SREESAIARJUN/radxa-cm4-nano-carrier/artifacts/rev11_hdmi_tmds_report.md

# Rev 11.0 - HDMI0 TMDS length-matching verification report

Generated by `python3 tools/hdmi_tmds.py verify` from the saved `.kicad_pcb` (lengths measured segment-by-segment by pcbnew, DRC by kicad-cli with the project `.kicad_dru`).

| # | Check | Result | Detail |
|---|---|---|---|
| 1 | J4 Micro-HDMI D (XUNPU HDMI-101S, LCSC C720620) present on B.Cu | PASS | radxa-cm4-nano-carrier:HDMI_Micro-D_XUNPU_HDMI-101S |
| 2 | J4 pinout = HDMI Type D (3/5 D2, 6/8 D1, 9/11 D0, 12/14 CLK, 4/7/10/13/16/shell GND, 1 HPD, 15 CEC, 17 SCL, 18 SDA, 19 +5V) | PASS | ok |
| 3 | J4 copper >= 0.30 mm from the Y=40 edge, mouth inside the outline (zero overhang) | PASS | front shell-pad copper Y 39.660 (gap 0.340); mouth Y 39.75 (recess 0.25 mm) |
| 4 | J4 courtyard clear of the H4 standoff keep-out (d6.2) | PASS | courtyard X 39.85..48.15; gap 0.25 mm |
| 5 | J4 courtyard does not overlap any other bottom-side part | PASS | clear |
| 6 | J4 through-hole shell legs clear of the J2 DF40 body on the top side | PASS | leftmost leg copper X 40.15 > DF40 body end X 36.3 |
| 7 | J4 orientation: rear row (D2/D0) Y 33.615, front row (D1/CLK) Y 34.835, mouth toward +Y | PASS | rear [33.615, 33.615], front [34.835, 34.835] |
| 8 | All 8 TMDS nets routed | PASS | 8/8 |
| 9 | Track width 0.165 mm on every TMDS segment | PASS | {'HDMI0_TX2_P': [0.165], 'HDMI0_TX2_N': [0.165], 'HDMI0_TX1_P': [0.165], 'HDMI0_TX1_N': [0.165], 'HDMI0_TX0_P': [0.165], 'HDMI0_TX0_N': [0.165], 'HDMI0_CLK_P': [0.165], 'HDMI0_CLK_N': [0.165]} |
| 10 | Exactly one F.Cu<->B.Cu via per TMDS net (via barrel cancels in all comparisons) | PASS | {'HDMI0_TX2_P': 1, 'HDMI0_TX2_N': 1, 'HDMI0_TX1_P': 1, 'HDMI0_TX1_N': 1, 'HDMI0_TX0_P': 1, 'HDMI0_TX0_N': 1, 'HDMI0_CLK_P': 1, 'HDMI0_CLK_N': 1} |
| 11 | Inter-pair: all 8 nets within 0.15 mm (max-min) | PASS | 45.1256 .. 45.1256 mm, spread 0.0 um = 0.000 ps |
| 12 | Intra-pair TX2: |P-N| <= 0.15 mm | PASS | P 45.1256  N 45.1256  skew 0.00 um = 0.0000 ps |
| 13 | Intra-pair TX1: |P-N| <= 0.15 mm | PASS | P 45.1256  N 45.1256  skew 0.00 um = 0.0000 ps |
| 14 | Intra-pair TX0: |P-N| <= 0.15 mm | PASS | P 45.1256  N 45.1256  skew 0.00 um = 0.0000 ps |
| 15 | Intra-pair CLK: |P-N| <= 0.15 mm | PASS | P 45.1256  N 45.1256  skew 0.00 um = 0.0000 ps |
| 16 | Coupled-section edge gap = 0.125 mm (+/-5 um) on every pair | PASS | TX2 0.1250..0.1250; TX1 0.1250..0.1250; TX0 0.1250..0.1250; CLK 0.1250..0.1250 |
| 17 | Longest contiguous uncoupled stretch <= 1.0 mm (5.5 ps << 50 ps edge; bumps, fan-outs and chamfers measured along the copper, trace inside its own pad excluded) | PASS | TX2 0.847 mm (coupled 78.8 % of copper); TX1 0.936 mm (coupled 82.7 % of copper); TX0 0.847 mm (coupled 80.7 % of copper); CLK 0.936 mm (coupled 83.6 % of copper) |
| 18 | Pair-to-pair copper gap >= 0.4 mm (no crossings) | PASS | min 0.400 mm (HDMI0_TX1_N/HDMI0_CLK_P on F.Cu) |
| 19 | Every TMDS segment runs over filled GND on its reference plane (In1 under F.Cu, In2 under B.Cu), incl. +/-0.28 mm lateral margin - never across the ETH_SHIELD split | PASS | 10827 samples, 0 off-plane (465 inside the 0.75 mm via-transition zones excluded) |
| 20 | GND return via (or grounded shell leg) within 2.0 mm of every TMDS layer-change via | PASS | HDMI0_CLK_N 1.33, HDMI0_CLK_P 0.93, HDMI0_TX0_N 1.72, HDMI0_TX0_P 1.72, HDMI0_TX1_N 0.93, HDMI0_TX1_P 1.33, HDMI0_TX2_N 1.38, HDMI0_TX2_P 0.73 |
| 21 | Insertion length (FR4, odd mode) within HDMI 2.0 carrier budget (< 60 mm) | PASS | 45.13 mm = 249.3 ps |
| 22 | kicad-cli DRC: 0 violations touching TMDS / J4 | PASS | 0 |
| 23 | kicad-cli: 0 unconnected TMDS items (J2 <-> J4 fully routed) | PASS | 0 |
| 24 | J4 GND pins 4 (D2 shield), 16 (DDC/CEC GND) and the shell legs are connected to GND | PASS | unconnected J4 GND pads: ['10', '13', '7'] |
| 25 | MUTATION caught: TMDS N trace +0.20 mm -> skew | PASS | 2 new 'skew_out_of_range' violation(s) on TMDS copper, e.g. Skew between traces out of range (rule 'hdmi0_tmds_skew_TX2' max skew 0.0750 mm; actual 0. |
| 26 | MUTATION caught: GND track 0.15 mm from a TMDS trace -> clearance (hdmi0_tmds_to_other) | PASS | 1 new 'clearance' violation(s) on TMDS copper, e.g. Clearance violation (rule 'hdmi0_tmds_to_other' clearance 0.2000 mm; actual 0.1500 mm) |

**26/26 checks passed.**

Informational (not gating):

- kicad-cli DRC, items NOT touching TMDS/J4 (owned by other stages, e.g. tools/ethernet_mdi.py): 9: silk_overlap 4, silk_over_copper 2, text_height 2, silk_edge_clearance 1
- J4 shield pins 7 (D1), 10 (D0), 13 (CLK) - KNOWN OPEN (no via/stub site in this escape; Rev 12 item): unconnected now: ['10', '13', '7']
- J4 low-speed nets not yet routed (HPD/CEC/DDC/+5V: out of Rev 11 scope): HDMI0_CEC, HDMI0_HOTPLUG, HDMI0_SCL, HDMI0_SDA

## Routed length per net (pad centre to pad centre, incl. stubs; 1 via each)

| Net | Length mm | vs longest um | Delta ps |
|---|---|---|---|
| HDMI0_TX2_P | 45.1256 | -0.0 | -0.000 |
| HDMI0_TX2_N | 45.1256 | -0.0 | -0.000 |
| HDMI0_TX1_P | 45.1256 | -0.0 | -0.000 |
| HDMI0_TX1_N | 45.1256 | +0.0 | +0.000 |
| HDMI0_TX0_P | 45.1256 | -0.0 | -0.000 |
| HDMI0_TX0_N | 45.1256 | -0.0 | -0.000 |
| HDMI0_CLK_P | 45.1256 | -0.0 | -0.000 |
| HDMI0_CLK_N | 45.1256 | -0.0 | -0.000 |

Odd-mode delay 5.523 ps/mm (eeff 2.742); HDMI 2.0 UI at 5.94 Gbit/s = 168.4 ps; 0.15 mm = 0.83 ps = 0.49 % UI.
