SREESAIARJUN/radxa-cm4-nano-carrier/artifacts/rev13_buck_3v3_report.md

# Rev 13 - SY8089AAAC +3V3_SYS buck: layout verification report

Generated by `python3 tools/buck_3v3.py verify` from the saved `.kicad_pcb` (measured, not planned).

**35/35 checks pass.**

| # | Check | Result | Detail |
|---|---|---|---|
| 1 | All 12 parts present (U5, U6, L1, C40-C44, R40-R43) | PASS | 12/12 |
| 2 | Pad-to-net map matches SY8089 / MAX809 pinouts + schematic intent (28 pads) | PASS | 28/28 |
| 3 | All power-stage parts on B.Cu (top side is under the CM4 module) | PASS |  |
| 4 | U5 / U6 pin positions = plan (mirror-correct flip) | PASS | max err 0.0 um |
| 5 | Every courtyard encloses its own pads (KiCad does not check this) | PASS | all |
| 6 | C41 (100 nF HF) pad edge <= 0.5 mm from U5 IN (pin 4) | PASS | 0.480 mm |
| 7 | C40 (22 uF bulk) pad edge <= 2.5 mm from U5 IN (pin 4) | PASS | 1.575 mm |
| 8 | U5 GND has an under-body via to L3 (hot-loop return directly beneath the IC) | PASS | (13.0, 4.9) |
| 9 | HF input loop plan-view area <= 4.0 mm^2 (C41 / IN / GND / under-body via) | PASS | 3.77 mm^2, perimeter 9.80 mm, est. L_loop ~6.63 nH (excl. package) |
| 10 | Bulk input loop plan-view area <= 8.0 mm^2 (C40) | PASS | 6.66 mm^2 |
| 11 | LX node copper area <= 12 mm^2 (pin 3 + trace + L1 pad; datasheet rule 3) | PASS | 9.29 mm^2 |
| 12 | LX trace length <= 3.0 mm | PASS | 2.35 mm |
| 13 | FB copper (tracks AND pads) >= 1.0 mm from any LX copper (true segment/box distance) | PASS | 1.61 mm |
| 14 | FB node trace length <= 5 mm (pin 5 -> divider) | PASS | 3.65 mm |
| 15 | VOUT sensed at C43 pad (Kelvin, after the output caps), not at L1 | PASS |  |
| 16 | Sense trace >= 0.7 mm from LX copper | PASS | 0.80 mm |
| 17 | +5V_IN / LX tracks >= 0.6 mm (2.4 A peak, 1 oz outer: < 10 C rise) | PASS | min 0.60 mm |
| 18 | Via count by net in the stage envelope (0.3 mm drill): +5V_IN >= 2, +3V3_SYS >= 2 hand-off, GND >= 8 | PASS | +5V_IN 2, +3V3_SYS 2, GND 10 (current capacity applies once the PDN stage connects the hand-offs) |
| 19 | All courtyards inside the cell envelope | PASS | courtyard bbox (3.35, 1.0, 23.93, 9.99) in (3.3, 0.3, 25.2, 10.05) |
| 20 | Courtyards >= 0.3 mm inside the 55 x 40 outline | PASS |  |
| 21 | No other stage's B.Cu courtyard / pad / track / via inside the cell envelope (+0.3 mm) | PASS | clear |
| 22 | Every courtyard clears every M2.5 standoff circle (r 3.1 mm) | PASS | min 3.21 mm (U6 to H1) |
| 23 | GND planes on L2 + L3 and local B.Cu GND island present | PASS | BUCK_GND_BCU@B.Cu, GND_In1@In1.Cu, GND_In2@In2.Cu |
| 24 | L3 GND copper is actually filled beneath U5 (hot-loop return plane present) | PASS |  |
| 25 | Every buck GND via lands in filled L3 GND (no via inside another stage's plane notch) | PASS | all |
| 26 | Buck COPPER >= 2.0 mm from any *SHIELD* zone (Ethernet chassis isolation gap) | PASS | 2.08 mm to ETH_SHIELD |
| 27 | Rev 13 DRC block + BUCK_POWER net class present in .kicad_dru / .kicad_pro | PASS | run `buck_3v3.py rules` if another stage dropped them |
| 28 | Electrical design checks (27) all pass | PASS | 0 failing |
| 29 | kicad-cli DRC: 0 violations touching the buck stage / cell (excl. documented hand-off vias) | PASS | 0 |
| 30 | Open hand-offs (informational):  | PASS | none |
| 31 | No hand-off left open on a net another stage has already routed | PASS | consistent |
| 32 | No unconnected items internal to the power stage (only the 2 documented inter-stage links remain) | PASS | 0 internal; 6 touching buck nets (J1 +5V_IN / +3V3_OUT / GND fan-out = next PDN stage) |
| 33 | NEGATIVE CONTROL: ungrouped 0.2 mm +5V_IN J1 fan-out NOT caught by buck_power_width | PASS | 0 width violations on the control stub |
| 34 | MUTATION caught: FB stub from U5 pin 5 to 0.7 mm of LX copper -> rule buck_fb_lx_isolation | PASS | clearance: Clearance violation (netclass 'Default' clearance 0.2000 mm; actual 0.; clearance: Clearance violation (rule 'buck_fb_lx_isolation' clearance 1.0000 mm; ; clearance: Clearance violation (zone clearance 0.2500 mm; actual 0.0000 mm) |
| 35 | MUTATION caught: +5V_IN 0.3 mm neck-down (member of REV13 group) from the VIN entry via -> rule buck_power_width | PASS | clearance: Clearance violation (zone clearance 0.2500 mm; actual 0.0000 mm); track_width: Track width (board setup constraints min width 0.5500 mm; actual 0.300 |

## Design calculation checks

| Check | Result | Detail |
|---|---|---|
| Vout setpoint within 1 % of 3.300 V | PASS | 0.6 x (1 + 100k/22.1k) = 3.3149 V |
| Vout DC worst case (VREF +/-2 %, R +/-0.35 %) inside 3.3 V +/-5 % | PASS | 3.230 .. 3.401 V (window 3.135 .. 3.465) |
| Divider resistors inside datasheet 10k..1M range | PASS | R1 100k, R2 22.1k, I_div 27.1 uA |
| Datasheet L rule: L >= Vout(1-Vout/Vin,max)/(fsw*0.4*Iout) | PASS | L_rule 1.53 uH -> 2.2 uH (FNR4030S2R2MT, also the datasheet's own typical value) |
| Ripple ratio at nominal L/fsw, VIN,max in 20%..40% | PASS | dI = 555 mA p-p = 27.8 % of 2.0 A |
| Worst-corner peak current < Isat (L -20 %, fsw -20 %, VIN 5.5 V) | PASS | Ipk 2.47 A vs Isat 5.8 A (dI_wc 935 mA) |
| Isat > IC current limit (no saturation during OCP / hic-cup) | PASS | Isat 5.8 A > ILIM,min 3.5 A (ILIM max not specified -> 66 % headroom) |
| Inductor RMS current < Irms rating | PASS | 2.018 A vs 3.2 A |
| Inductor DCR < 50 mOhm (datasheet efficiency guideline) | PASS | 39 mOhm |
| Ripple stays >= 10 % at the low corner (current-mode ramp / light-load PFM entry) | PASS | dI_min 316 mA (15.8 %) at VIN 4.75 V, L +20 %, fsw +20 % |
| Min on-time margin (D_min / fsw,max >> 75 ns) | PASS | ton = 502 ns at VIN 5.5 V, fsw +20 % (limit 75 ns) |
| Regulation headroom at 2 A (100 % duty dropout) below VIN,min | PASS | VIN needed 3.72 V vs USB VIN,min 4.75 V (D_max 77.5 %) |
| Cin RMS ripple current handled by 22 uF X5R (self-heating < 10 mW) | PASS | I_rms 0.945 A (worst VIN=2Vout bound 1.00 A), P_ESR 4.0 mW |
| Input ripple at IN pin, worst USB VIN corner 4.75..5.25 V (C -20 %, fsw -20 %, L -20 %, DC-bias derated) | PASS | dVin 95.8 mV p-p at VIN 5.25 V (C_eff 6.8 uF) vs 100 mV; 106 mV at the 5.5 V IC limit (outside USB VBUS range) |
| Output ripple (worst corner) < 1 % Vout | PASS | dVout 9.81 mV p-p (C_eff 18.4 uF) |
| 1 A load-step LC energy deviation (inductor slew bound) < 3 % Vout | PASS | undershoot 50.0 mV, overshoot 21.6 mV (lower bound; loop-delay term measured on the bench) |
| Vout TOTAL window (DC + IFB*R1 + ripple/2 + 1 A step) inside 3.3 V +/-5 % | PASS | 3.170 .. 3.432 V (margins 35 / 33 mV) |
| Cff phase-boost centre within 0.5x..2x of the datasheet-validated network | PASS | zero 33.9 kHz, pole 187 kHz, max boost 44 deg at 80 kHz (datasheet 1.8 V example: 63 kHz); LC pole 22.4 kHz |
| Same L / Cout as datasheet typical application (internal compensation validated region) | PASS | 2.2 uH, 2 x 22 uF |
| Soft-start Cout charge current << ILIM | PASS | 122 mA over 1.2 ms |
| EN high level (U6 VOH = +3V3_OUT) >= VIH 1.5 V and <= VIN + 0.6 V | PASS | V_EN 3.27 V |
| Power-down: +3V3_SYS shut off while +3V3_OUT >= Vth,min, back-bias < ESD onset | PASS | U6 trips at +3V3_OUT 2.85..3.00 V -> max +3V3_SYS - +3V3_OUT 0.58 V < 0.6 V (plain 10k/1M from +3V3_OUT: EN-off only below 0.40 V) |
| Power-up: buck enabled >= 140 ms after +3V3_OUT valid (module rail first) | PASS | t_RP 140 ms min; RESET# low for VCC 1.0 V..Vth; R43 1M holds EN low with module absent |
| EN clamp current limited if +5V_IN collapses first (10k series) | PASS | <= 0.29 mA into EN ESD diode with VIN = 0 |
| Efficiency at 2 A / 5 V >= 88 % | PASS | 89.7 % (1 A: 94.5 %), P_IC 606 mW, P_L+div 157 mW |
| TJ <= 125 C at 2 A, TA 50 C (board-estimated thetaJA, self-consistent RDS(on)(TJ)) | PASS | TJ 120 C @ 115 C/W (166 C @ datasheet 170 C/W) |
| Carrier 3V3 load budget 1.2 A <= derated limit at TA 70 C (datasheet thetaJA, conservative) | PASS | I_max(70 C) = 1.42 A @170 C/W, 1.75 A @115 C/W |

## Thermal derating (TJ <= 125 C)

| TA (C) | I_max @ 170 C/W (datasheet) | I_max @ 115 C/W (board est.) |
|---|---|---|
| 25 | 1.95 A | 2.00 A |
| 40 | 1.79 A | 2.00 A |
| 50 | 1.68 A | 2.00 A |
| 60 | 1.55 A | 1.91 A |
| 70 | 1.42 A | 1.75 A |
| 85 | 1.19 A | 1.47 A |

kicad-cli DRC (whole board): 9 violations, 59 unconnected items (board-wide; most are the J1/J2 fan-out owned by later stages).
