SREESAIARJUN/radxa-cm4-nano-carrier/artifacts/rev17_power_seq_report.md

# Rev 17 - Power sequencing (GLOBAL_EN / RUN / PWR_OK): verification report

Generated by `python3 tools/power_sequencing.py verify` from the saved `.kicad_pcb` (measured, not planned).

**20/20 layout checks pass.**

| # | Check | Result | Detail |
|---|---|---|---|
| 1 | All 9 Rev 17 parts present (R55, R54, R56, R51, R52, U8, R53, C50, U7) | PASS |  |
| 2 | Stage items grouped in REV17_PWR_SEQ (additive / idempotent regeneration) | PASS | 64 items |
| 3 | Pad-to-net map = MIC803 / TPS3808 DBV pinouts + schematic intent | PASS | all pads |
| 4 | Pad positions = plan (incl. mirrored B.Cu parts) | PASS | max err 0.0 um |
| 5 | Layer assignment: links + bridge on F.Cu, supervisors on B.Cu | PASS |  |
| 6 | Default (RADXA) build: U7, R54, R55 DNP; R51, R52, R53, R56, U8, C50 fitted | PASS | matches VARIANTS |
| 7 | Default build: J1 pin 99 (GLOBAL_EN) has no fitted carrier part (no pull-up, no driver) | PASS | attached: R54(DNP) |
| 8 | Default build: J1 pin 92 (RUN_PG) has no fitted carrier part (no pull-up, no driver) | PASS | attached: R55(DNP) |
| 9 | Default build: J1 pin 100 (nEXTRST) has no fitted carrier part (no pull-up, no driver) | PASS | attached: none |
| 10 | Rev 13 hand-off closed: J1 +3V3_OUT (84/86) copper-connected to U6 VCC (MAX809 pin 3) | PASS | continuous F.Cu trace under the R55/R54/R56 0603 bridges, south run y = 9.98 mm |
| 11 | Top-side (under-module) parts <= 1.2 mm | PASS | R51/R52 0402 0.4 mm, R54/R55/R56 0603 0.55 mm |
| 12 | Rev 17 copper >= 1.70 mm lateral from the ETH_SHIELD inner-layer island (3-D >= 1.71 mm through 7628 prepreg; the only sub-2 mm item is the forced +3V3_OUT south run) | PASS | min 1.74 mm lateral / 1.76 mm 3-D (+3V3_OUT @(18.20,5.25)) |
| 13 | Every courtyard clears every M2.5 standoff circle (r 3.1 mm) | PASS | min 13.30 mm |
| 14 | Every Rev 17 GND via lands in filled L2 AND L3 GND | PASS | all |
| 15 | Rev 17 DRC block present in .kicad_dru | PASS | run `power_sequencing.py rules` if dropped |
| 16 | Sequencing design checks (25) all pass | PASS | 0 failing |
| 17 | kicad-cli DRC: 0 violations touching Rev 17 items / nets | PASS | 0 |
| 18 | No unconnected items on Rev 17 nets | PASS | 0 (2 J1/J2 GND-pad fan-out gaps pre-date Rev 17 and merely pair with the nearest GND via) |
| 19 | MUTATION caught: GND stub 0.225 mm from the RUN_PG trace (passes the 0.2 mm default, must trip only -> pseq_module_pin_isolation | PASS | Clearance violation (rule 'pseq_module_pin_isolation' clearance 0.2500 mm; actua; Track has unconnected end |
| 20 | Schematic: 9 Rev 17 symbols, DNP flags = board, ERC clean except the 3 J1/buck-side labels (GLOBAL_EN, RUN_PG, +5V_IN: J1 and the buck are not in the schematic yet) | PASS | symbols ok, DNP ok, 0 unexpected ERC items |

## Sequencing design checks (`calc`)

| Check | Result | Detail |
|---|---|---|
| U7 max threshold < +5V_IN minimum 4.75 V (a valid supply is never held off) | PASS | VTH,max 4.50 V, margin 250 mV |
| U7 min threshold > MxL7704 UVLO-rising max 3.9 V (GLOBAL_EN asserted before the PMIC can start) | PASS | VTH,min 4.25 V |
| U7 /RESET abs max >= GLOBAL_EN released level (5.25 V, 100k to +5V on CM4) | PASS | 6.0 V >= 5.25 V |
| GLOBAL_EN low level <= 0.8 V (MxL7704 VIL) with 100k module pull-up | PASS | VOL <= 0.3 V at 52 uA sink |
| GLOBAL_EN released level >= 2.0 V (MxL7704 VIH) with U7 leakage | PASS | 4.65 V |
| Power-on GLOBAL_EN low pulse > 1 ms (CM4 restart minimum) | PASS | 140..360 ms after VIN > VTH |
| PWR_OK rising threshold (max, incl. 3 % hysteresis) < +3V3_SYS minimum | PASS | 3.168 V < 3.234 V (margin 66 mV) |
| PWR_OK falling threshold (min) >= lowest +3V3_SYS peripheral VDD 2.7 V | PASS | VIT- 2.756 / 2.912 / 3.076 V |
| SENSE input current error negligible (< 0.5 % of VIT) | PASS | 0.22 mV at Rth 8.61 k |
| U8 VDD (+5V_IN) inside 1.7..6.5 V across the input window | PASS | 4.75..5.25 V |
| PWR_OK valid while +3V3_SYS = 0 V (VDD from always-on +5V_IN, VPOR 0.8 V) | PASS | RESET low from VDD 0.8 V; supervisor NOT powered from the rail it monitors |
| PWR_OK high (R51 100k to +3V3_SYS, RADXA build) >= 2.0 V with 300 nA leakage | PASS | 3.20 V |
| RUN_PG low (RPi build: 10k module pull-up, 220R series, U8 VOL) <= 0.8 V | PASS | 200 mV at 0.32 mA |
| [RADXA (default: RK3566 / RK3576 / RK3588)] R51 (pull-up) and R55 (RUN link) never both fitted | PASS | R51=fit, R55=DNP |
| [RPI_CM4] R51 (pull-up) and R55 (RUN link) never both fitted | PASS | R51=DNP, R55=fit |
| [default build] RPi CM4 (BCM2711 + MxL7704): no static drive on pin 99 / pin 92 unless the module allows it | PASS | pin 99: released; pin 92: released |
| [default build] Radxa CM3 (RK3566 + RK817-5): no static drive on pin 99 / pin 92 unless the module allows it | PASS | pin 99: released; pin 92: released |
| [default build] Radxa CM4 (RK3576 + RK806S-5): no static drive on pin 99 / pin 92 unless the module allows it | PASS | pin 99: released; pin 92: released |
| [default build] Radxa CM5 (RK3588S + RK806-1): no static drive on pin 99 / pin 92 unless the module allows it | PASS | pin 99: released; pin 92: released |
| [RPI_CM4 build] drives only what the RPi CM4 datasheet allows (GLOBAL_EN hold-off, RUN via 220R) | PASS | R54 + R55 fitted, R51 DNP |
| Added capacitance on pin 92 <= 100 nF (RK806 RESETB total <= 0.3 uF, module already ~110 nF) | PASS | 0 nF: only a DNP 0402 pad (~0.1 pF) + trace (~1 pF) |
| Boot-critical rail rule R17-1: +3V3_SYS valid only 141..462 ms after module 3V3, i.e. AFTER every Rockchip reset release (2..16 ms) -> no BootROM device may sit on +3V3_SYS | PASS | requirement recorded in specs/carrier_specs.md; RPi build additionally holds RUN until PWR_OK |
| [RPI_CM4 build] RUN_PG held until PWR_OK: worst-case boot delay < 1 s | PASS | PWR_OK at 153..490 ms after module 3V3 |
| Power-down: PWR_OK asserts (falling VIT max) above the peripheral minimum 2.7 V | PASS | asserts between 2.76 and 3.08 V, tpd 20 us |
| Rejected: replacing U6 by TLV809EC26 (10 ms) - still misses RK806 reset (>= 6.5+0.8 ms vs 5 ms) and raises power-down back-bias above the 0.6 V ESD limit | PASS | back-bias 0.78 V; keep MAX809 + rule R17-1 instead |

## Module compatibility matrix

| Module | Pin 99 | Pin 92 | SoC reset release after module 3V3 | Source |
|---|---|---|---|---|
| RPi CM4 (BCM2711 + MxL7704) | GLOBAL_EN: 100k to +5V, low = PMIC off; hold-off is the intended use | RUN_PG: 10k to 3V3, may be held low via 220R (CPU reset) | 11 ms+ | CM4 datasheet 5.1: +1V8 >= 1 ms after 3V3, RUN_PG >= 10 ms after 1V8; pins 92/99 rows |
| Radxa CM3 (RK3566 + RK817-5) | PWRON_KEY: RK817 PWRON, 17k to VCC_RTC; > 6 s low = OFF (no auto restart with 5 V present) | PMIC_SLEEP_H push-pull SoC output (V1.3) / NC (V1.2) | 2..12 ms | RK817 DS V1.7 4.1.2-4.1.4; Radxa CM3 schematic V1.2 sh.21/23; RK3566 HDG V1.1 (2 ms slots) |
| Radxa CM4 (RK3576 + RK806S-5) | PWRON_L: RK806S PWRON, ~45k to VCCA = 5V; VDC strapped high -> cannot be held off | RESET_L: NPOR + RK806S RESETB, 10k to 1V8; low while ON = PMIC restart | 0..16 ms | Radxa CM4 schematic V1.20 sh.5/19; RK806S DS Rev1.5 4.1.2/4.1.4 (RESETB slot 12) |
| Radxa CM5 (RK3588S + RK806-1) | PWRON_L: RK806 PWRON, ~45k to VCCA = 5V + 100nF; VDC strapped high | RESET_L: NPOR + RK806 RESETB, 10k to 1V8 + 100nF; low while ON = PMIC restart | 5..5 ms | Radxa CM5 X2.1/V2.21 schematic p.8/18; RK806 DS V1.2 Table 4-1 (3V3 slot 6, RESETB slot 11) |

Carrier: +3V3_SYS valid 141..462 ms, PWR_OK 153..490 ms after module 3V3 (U6 MAX809 tRP + SY8089 soft-start + U8 td).

## Assembly variants

| Build | U7 | R54 | R55 | R51 |
|---|---|---|---|---|
| RADXA (default: RK3566 / RK3576 / RK3588) | DNP | DNP | DNP | fit |
| RPI_CM4 | fit | fit | fit | DNP |

kicad-cli DRC (whole board): 9 violations, 59 unconnected (board-wide; other stages' items are reported by their own verifiers).
