SREESAIARJUN/radxa-cm4-nano-carrier/artifacts/rev9_mdi_si_report.md

# Rev 9.0 Gigabit Ethernet MDI - Signal-Integrity & DRC Report

Generated by `tools/ethernet_mdi.py verify`. Impedance source of truth: `tools/mdi_impedance.py`.

**Overall: FAIL** (30/31 checks)

## Impedance (JLC04161H-7628, L4 over L3 / L1 over L2)

| Model | Zdiff | Zodd | Zcomm |
|---|---|---|---|
| 2-D FD field solver, solder-masked (sign-off) | 100.03 | 50.01 | 44.20 |
| 2-D FD field solver, bare copper | 104.71 | 52.35 | 45.06 |
| Kirschning-Jansen closed form, bare | 111.06 | 55.53 | 44.70 |

Geometry W = 0.165 mm, S = 0.125 mm, pitch 0.290 mm; eeff(odd) 2.742 -> 5.523 ps/mm.

## Intra-pair lengths (track + one 1.5512 mm F.Cu->B.Cu barrel per via, as KiCad's skew rule counts them)

| Segment | P (mm) | N (mm) | Skew (mm) | Uncoupled (mm, P leg) |
|---|---|---|---|---|
| PHY0 | 42.945 | 42.945 | 0.000 | 8.76 |
| PHY1 | 28.921 | 28.921 | 0.000 | 4.71 |
| PHY2 | 39.865 | 39.865 | 0.000 | 6.29 |
| PHY3 | 26.109 | 26.109 | 0.000 | 4.74 |
| CAB0 | 7.981 | 7.981 | 0.000 | 3.76 |
| CAB1 | 7.529 | 7.529 | 0.000 | 7.53 |
| CAB2 | 11.599 | 11.599 | 0.000 | 5.13 |
| CAB3 | 7.455 | 7.455 | 0.000 | 3.76 |

## Checks

| ID | Check | Result | Detail |
|---|---|---|---|
| STK-prepreg | board stackup L1-L2 / L3-L4 prepreg == impedance model | PASS | h=0.2104 er=4.4 |
| PRO-netclass | ETH_MDI_100R (W 0.165 / gap 0.125 / via 0.5/0.3) + patterns present in .kicad_pro | PASS | classes ['Default', 'BUCK_POWER', 'ETH_MDI_100R', 'HDMI_TMDS']; patterns ['ETH_MDI*', 'Ethernet_Pair*'] |
| DRU-block | Rev 9 DRU block present (net-name conditions; skew constraint = half the P-N limit) | PASS |  |
| ZDIFF-fd | field-solver Zdiff of W0.165/S0.125 within +/-3 % of 100 ohm | PASS | 100.03 ohm |
| NET-count | 16 MDI nets routed (4 PHY-side + 4 cable-side pairs) | PASS | ETH_MDI0_N, ETH_MDI0_P, ETH_MDI1_N, ETH_MDI1_P, ETH_MDI2_N, ETH_MDI2_P, ETH_MDI3_N, ETH_MDI3_P, Ethernet_Pair0_N, Ethernet_Pair0_P, Ethernet_Pair1_N, Ethernet_Pair1_P, Ethernet_Pair2_N, Ethernet_Pair2_P, Ethernet_Pair3_N, Ethernet_Pair3_P |
| GEO-width | every MDI segment is 0.165 mm wide | PASS | [0.165] |
| MAP-t568 | CM4 Pair0..3 -> T1 TD1..TD4 -> MX1..MX4 -> RJ45 1/2, 3/6, 4/5, 7/8 (T568) | PASS | all 16 |
| MAP-polarity | end-to-end polarity: Pair_P and MDI_P on the same winding end (dot/non-dot) of the same channel; MDI_P on RJ45 '+' | PASS |  |
| MAP-j1 | J1 pins 3..12 carry Ethernet_Pair0..3 per CM4 pinout | PASS |  |
| LEN-skew | intra-pair length mismatch <= 0.15 mm (all 8 pair segments) | PASS | PHY0 42.945/42.945 d=0.000; PHY1 28.921/28.921 d=0.000; PHY2 39.865/39.865 d=0.000; PHY3 26.109/26.109 d=0.000; CAB0 7.981/7.981 d=0.000; CAB1 7.529/7.529 d=0.000; CAB2 11.599/11.599 d=0.000; CAB3 7.455/7.455 d=0.000 |
| LEN-total | each side <= 50.0 mm (PHY pin->T1, T1->RJ45) | PASS | max 42.95 mm; J1->RJ45 totals 50.9, 36.5, 51.5, 33.6 mm |
| CPL-uncoupled | uncoupled length per net <= 10.0 mm (DRU diff_pair_uncoupled) | PASS | PHY0 8.76; PHY1 4.71; PHY2 6.29; PHY3 4.74; CAB0 3.76; CAB1 7.53; CAB2 5.13; CAB3 3.76 |
| CPL-RL | uncoupled sections' return-loss contribution < -30 dB at 100 MHz | PASS | Zdiff(uncoupled) 141.7 ohm, worst PHY0: 8.76 mm -> -39.6 dB |
| SPC-interpair | pair-to-pair edge spacing >= 0.3 mm (DRU mdi_interpair) | PASS | min 0.495 mm (Ethernet_Pair0_N/Ethernet_Pair2_P) |
| GEO-gap | no intra-pair pinch: min P-N edge gap >= coupled gap 0.125 mm (centre pitch 0.290) | PASS | min 0.125 mm (PHY0) |
| REF-plane | every MDI segment has a solid plane directly beneath (In1 for F.Cu, In2 for B.Cu) | PASS | 0 voids |
| REF-domain | PHY-side pairs over GND, cable-side pairs over ETH_SHIELD (never across the split) | PASS | 0 crossings |
| MECH-side | T1, J3 and 1206 HV parts on the bottom side (top side is under the module, <= 1.2 mm) | PASS |  |
| MECH-top-height | top-side Ethernet passives are 0402 (<= 0.55 mm) under the 1.2 mm limit | PASS | 8 top-side parts; non-0402: none |
| MECH-envelope | T1/J3 courtyards inside 55 x 40 outline (zero overhang) | PASS | T1 (25.45, 10.96, 42.55, 29.05), J3 (0.3, 12.4, 21.89, 27.59) |
| DRC-eth | kicad-cli DRC: 0 violations involving any Rev 9 item (group REV9_ETH_MDI) or Ethernet net | PASS | 0 |
| DRC-unrouted | no unrouted Ethernet connections (all 16 MDI + CT/BS/shield nets complete) | PASS | 0 |
| DRC-other | pre-existing non-Ethernet DRC items (informational) | PASS | 9 violations, 59 unrouted (J1/J2 module nets / other stages) |
| MUT-track_width | DRU catches mutation: MDI segment widened to 0.25 mm -> track_width | PASS | 1 matching 'track_width' violations; types ['clearance', 'silk_edge_clearance', 'silk_over_copper', 'silk_overlap', 'text_height', 'track_width'] |
| MUT-mdi_isolation | DRU catches mutation: GND track 0.25 mm from an MDI band -> mdi_isolation | PASS | 1 matching 'clearance' violations; types ['clearance', 'silk_edge_clearance', 'silk_over_copper', 'silk_overlap', 'text_height', 'track_dangling'] |
| MUT-mdi_interpair | DRU catches mutation: foreign MDI pair 0.25 mm from Pair 2 -> mdi_interpair | PASS | 1 matching 'clearance' violations; types ['clearance', 'silk_edge_clearance', 'silk_over_copper', 'silk_overlap', 'skew_out_of_range', 'text_height', 'track_dangling', 'track_width'] |
| MUT-skew | DRU catches mutation: 0.20 mm stub on ETH_MDI3_N -> skew | PASS | 2 matching 'skew_out_of_range' violations; types ['silk_edge_clearance', 'silk_over_copper', 'silk_overlap', 'skew_out_of_range', 'text_height'] |
| MUT-via_count | DRU catches mutation: 3rd via on Ethernet_Pair3_P -> via_count | **FAIL** | 0 matching 'too_many_vias' violations; types ['clearance', 'hole_clearance', 'shorting_items', 'silk_edge_clearance', 'silk_over_copper', 'silk_overlap', 'text_height'] |
| MUT-eth_shield_split | DRU catches mutation: ETH_BS via inside the 2 mm split -> eth_shield_split | PASS | 2 matching 'clearance' violations; types ['clearance', 'silk_edge_clearance', 'silk_over_copper', 'silk_overlap', 'text_height', 'via_dangling'] |
| SCH-erc | schematic ERC: no violations on Rev 9 symbols (only the 8 J1-side Ethernet_PairN labels dangle) | PASS | 8 total; unexpected: none |
| SCH-parity | schematic <-> PCB parity clean for T1, J3, C10..C15, R10..R14 (refs, values, footprints, nets) | PASS | 0 Rev 9 parity items (32 board-wide, J1/J2/other stages) |
