SREESAIARJUN/radxa-cm4-nano-carrier/artifacts/rev15_thermal_report.md

# Rev 15 - 15 W continuous-load thermal study: heat pipe vs. solid thermal pedestal

Generated by `python3 tools/thermal_15w.py calc` (do not hand-edit). Inputs, sources and assumptions are listed in the tool header; every [A] assumption is swept below.

**Recommended concept: B1** - Cu block + 6 mm flattened sintered heat pipe -> 135x100x20 remote sink (natural).  **18/19 gating checks pass**; 7/7 solver self-tests pass.

## 0. Decision matrix (gate: TA 40 C, 15 W at the SoC, worst-case TIM)

Rule: meet TJ <= 80 C at TA 40 C with worst-case TIM AND mass on the module <= 60 g; passive preferred over fan (no wear-out item, no acoustic noise); then lowest TJ.

| Concept | TJ worst TIM | thermal gate | mass on module | mass gate | feasible |
|---|---|---|---|---|---|
| A5 | 76.0 C | PASS | 53 g | PASS | **yes** |
| B1 **(recommended)** | 79.0 C | PASS | 23 g | PASS | **yes** |
| A4 | 80.2 C | fail | 237 g | fail | no |
| A3 | 96.8 C | fail | 53 g | PASS | no |
| A2 | 100.5 C | fail | 237 g | fail | no |
| A1 | 154.2 C | fail | 37 g | PASS | no |

## 1. Junction temperature, 15 W concentrated at the SoC

| Concept | TA | TJ nom | TJ worst TIM | T_case | T_sink root | T_module (DF40) | T_carrier | R_sa K/W | R_ja,eff K/W | fins / gap |
|---|---|---|---|---|---|---|---|---|---|---|
| A1 | 25 | 137.3 | 140.0 | 134.5 | 109.8 | 114.1 | 101.1 | 6.72 | 7.01 | 10 / 5.0 mm |
| A1 | 40 | 151.6 | 154.2 | 148.8 | 124.2 | 128.2 | 114.8 | 6.74 | 6.97 | 9 / 5.8 mm |
| A1 | 50 | 161.0 | 163.6 | 158.2 | 133.6 | 137.5 | 123.8 | 6.74 | 6.93 | 9 / 5.8 mm |
| A2 | 25 | 82.7 | 85.6 | 79.8 | 52.8 | 62.2 | 61.3 | 1.89 | 3.60 | 16 / 7.9 mm |
| A2 | 40 | 97.7 | 100.5 | 94.8 | 67.8 | 77.1 | 75.8 | 1.90 | 3.60 | 16 / 7.9 mm |
| A2 | 50 | 107.6 | 110.4 | 104.7 | 77.7 | 86.8 | 85.4 | 1.90 | 3.59 | 15 / 8.6 mm |
| A3 | 25 | 78.6 | 81.5 | 75.6 | 49.6 | 59.0 | 58.8 | 1.66 | 3.35 | 20 / 1.8 mm |
| A3 | 40 | 93.9 | 96.8 | 91.0 | 65.0 | 74.1 | 73.6 | 1.70 | 3.37 | 19 / 2.0 mm |
| A3 | 50 | 104.0 | 106.9 | 101.1 | 75.2 | 84.2 | 83.3 | 1.71 | 3.38 | 19 / 2.0 mm |
| A4 | 25 | 65.1 | 65.1 | 61.7 | 53.1 | 56.9 | 57.2 | 1.89 | 2.51 | 16 / 7.9 mm |
| A4 | 40 | 80.2 | 80.2 | 76.8 | 68.1 | 71.8 | 71.7 | 1.90 | 2.51 | 16 / 7.9 mm |
| A4 | 50 | 90.0 | 90.0 | 86.6 | 78.0 | 81.6 | 81.3 | 1.89 | 2.50 | 15 / 8.6 mm |
| A5 | 25 | 60.6 | 60.6 | 57.1 | 49.9 | 53.5 | 54.5 | 1.66 | 2.22 | 20 / 1.8 mm |
| A5 | 40 | 76.0 | 76.0 | 72.5 | 65.3 | 68.8 | 69.4 | 1.70 | 2.25 | 19 / 2.0 mm |
| A5 | 50 | 86.2 | 86.2 | 82.7 | 75.5 | 78.8 | 79.2 | 1.71 | 2.26 | 19 / 2.0 mm |
| B1 | 25 | 64.1 | 64.1 | 60.6 | 52.6 | 57.7 | 57.9 | 1.90 | 2.44 | 16 / 7.9 mm |
| B1 | 40 | 79.0 | 79.0 | 75.5 | 67.6 | 72.5 | 72.3 | 1.91 | 2.43 | 16 / 7.9 mm |
| B1 | 50 | 88.8 | 88.8 | 85.3 | 77.5 | 82.3 | 81.9 | 1.90 | 2.42 | 15 / 8.6 mm |

## 2. Distributed load (11.5 W SoC + 3.5 W DRAM/PMIC/eMMC into the module PCB)

| Concept | TA | TJ nom | T_module | T_carrier |
|---|---|---|---|---|
| A1 | 25 | 131.7 | 118.2 | 104.2 |
| A1 | 40 | 146.0 | 132.2 | 117.8 |
| A1 | 50 | 155.3 | 141.4 | 126.7 |
| A2 | 25 | 77.7 | 67.1 | 65.1 |
| A2 | 40 | 92.6 | 81.9 | 79.5 |
| A2 | 50 | 102.5 | 91.6 | 89.0 |
| A3 | 25 | 73.7 | 63.8 | 62.6 |
| A3 | 40 | 89.0 | 79.0 | 77.3 |
| A3 | 50 | 99.1 | 88.9 | 87.0 |
| A4 | 25 | 62.9 | 62.6 | 61.6 |
| A4 | 40 | 77.9 | 77.4 | 76.1 |
| A4 | 50 | 87.8 | 87.2 | 85.7 |
| A5 | 25 | 58.6 | 59.3 | 59.0 |
| A5 | 40 | 73.9 | 74.4 | 73.8 |
| A5 | 50 | 84.1 | 84.5 | 83.6 |
| B1 | 25 | 62.3 | 63.8 | 62.6 |
| B1 | 40 | 77.2 | 78.6 | 77.0 |
| B1 | 50 | 87.0 | 88.3 | 86.5 |

## 2b. Governed operation (OS throttles at 85 C): power and board temperatures actually reached

| Concept | load | TA | P W | TJ | T_module (DF40) | T_carrier (buck ambient) |
|---|---|---|---|---|---|---|
| A1 | concentrated | 25 | 6.7 | 85.0 | 75.1 | 71.3 |
| A1 | concentrated | 40 | 4.6 | 85.0 | 78.4 | 76.9 |
| A1 | concentrated | 50 | 3.3 | 85.0 | 80.5 | 80.5 |
| A1 | distributed | 25 | 7.1 | 85.0 | 79.1 | 74.4 |
| A1 | distributed | 40 | 4.8 | 85.0 | 81.2 | 79.0 |
| A1 | distributed | 50 | 3.4 | 85.0 | 82.5 | 82.0 |
| A2 | concentrated | 25 | 15.0 | 82.7 | 62.2 | 61.3 |
| A2 | concentrated | 40 | 11.2 | 85.0 | 69.8 | 70.2 |
| A2 | concentrated | 50 | 8.4 | 85.0 | 73.9 | 75.4 |
| A2 | distributed | 25 | 15.0 | 77.7 | 67.1 | 65.1 |
| A2 | distributed | 40 | 12.5 | 85.0 | 76.2 | 75.2 |
| A2 | distributed | 50 | 9.3 | 85.0 | 78.7 | 79.1 |
| A3 | concentrated | 25 | 15.0 | 78.6 | 59.0 | 58.8 |
| A3 | concentrated | 40 | 12.4 | 85.0 | 68.9 | 69.5 |
| A3 | concentrated | 50 | 9.5 | 85.0 | 72.9 | 74.6 |
| A3 | distributed | 25 | 15.0 | 73.7 | 63.8 | 62.6 |
| A3 | distributed | 40 | 13.7 | 85.0 | 76.0 | 75.0 |
| A3 | distributed | 50 | 10.5 | 85.0 | 78.3 | 78.8 |
| A4 | concentrated | 25 | 15.0 | 65.1 | 56.9 | 57.2 |
| A4 | concentrated | 40 | 15.0 | 80.2 | 71.8 | 71.7 |
| A4 | concentrated | 50 | 12.7 | 85.0 | 78.0 | 78.6 |
| A4 | distributed | 25 | 15.0 | 62.9 | 62.6 | 61.6 |
| A4 | distributed | 40 | 15.0 | 77.9 | 77.4 | 76.1 |
| A4 | distributed | 50 | 13.6 | 85.0 | 84.6 | 83.6 |
| A5 | concentrated | 25 | 15.0 | 60.6 | 53.5 | 54.5 |
| A5 | concentrated | 40 | 15.0 | 76.0 | 68.8 | 69.4 |
| A5 | concentrated | 50 | 14.5 | 85.0 | 78.0 | 78.6 |
| A5 | distributed | 25 | 15.0 | 58.6 | 59.3 | 59.0 |
| A5 | distributed | 40 | 15.0 | 73.9 | 74.4 | 73.8 |
| A5 | distributed | 50 | 15.0 | 84.1 | 84.5 | 83.6 |
| B1 | concentrated | 25 | 15.0 | 64.1 | 57.7 | 57.9 |
| B1 | concentrated | 40 | 15.0 | 79.0 | 72.5 | 72.3 |
| B1 | concentrated | 50 | 13.2 | 85.0 | 79.4 | 79.6 |
| B1 | distributed | 25 | 15.0 | 62.3 | 63.8 | 62.6 |
| B1 | distributed | 40 | 15.0 | 77.2 | 78.6 | 77.0 |
| B1 | distributed | 50 | 14.0 | 85.0 | 86.3 | 84.9 |

## 3. Thermal resistance breakdown at the gate corner (TA 40 C, 15 W, nominal TIM), K/W

- **A1** - tim 1.823, pedestal 0.133, pedestal_sp 0.076, base 0.268, base_sp 0.261; R_sa 6.74; h 8.9 W/m2K.  Heat flows: sink 12.49 W, module_surface 0.61 W, carrier 2.91 W, jb 3.90 W, module_to_carrier 1.90 W, module_to_dissipator 1.39 W.
- **A2** - tim 1.823, pedestal 0.132, pedestal_sp 0.076, base 0.378, base_sp 0.377; R_sa 1.90; h 5.2 W/m2K.  Heat flows: sink 14.63 W, module_surface 0.21 W, carrier 1.18 W, jb 3.44 W, module_to_carrier 0.16 W, module_to_dissipator 3.07 W.
- **A3** - tim 1.823, pedestal 0.132, pedestal_sp 0.075, base 0.265, base_sp 0.258; R_sa 1.70; h 33.6 W/m2K; fan operating point 2.08 CFM @ 6.9 Pa, channel 1.81 m/s.  Heat flows: sink 14.74 W, module_surface 0.19 W, carrier 1.09 W, jb 3.29 W, module_to_carrier 0.08 W, module_to_dissipator 3.03 W.
- **A4** - tim 0.125, pedestal 0.132, pedestal_sp 0.076, base 0.378, base_sp 0.377; R_sa 1.90; h 5.2 W/m2K.  Heat flows: sink 14.82 W, module_surface 0.17 W, carrier 1.02 W, jb 1.40 W, module_to_carrier 0.01 W, module_to_dissipator 1.22 W.
- **A5** - tim 0.125, pedestal 0.132, pedestal_sp 0.075, base 0.265, base_sp 0.258; R_sa 1.70; h 33.6 W/m2K; fan operating point 2.08 CFM @ 6.9 Pa, channel 1.81 m/s.  Heat flows: sink 14.93 W, module_surface 0.15 W, carrier 0.93 W, jb 1.20 W, module_to_carrier -0.08 W, module_to_dissipator 1.13 W.
- **B1** - tim 0.125, block_and_evap 0.229, vapour 0.003, condenser 0.025, base 0.174, base_sp 0.172; R_sa 1.91; h 5.1 W/m2K.  Heat flows: sink 14.50 W, module_surface 0.48 W, carrier 1.04 W, jb 1.08 W, module_to_carrier 0.03 W, module_to_dissipator 0.57 W.

## 4. Sustained power before the 85 C trip, transient and mass

| Concept | P_sustain 25 C | 40 C | 50 C | 40 C worst TIM | t to 85 C trip @40 C | tau63 | TJ after 4 h (steady) | dissipator mass | on module |
|---|---|---|---|---|---|---|---|---|---|
| A1 | 6.7 W | 4.6 W | 3.3 W | 4.5 W | 1.3 min | 5.1 min | 124.7 C (151.6) | 33 g | 37 g |
| A2 | 15.7 W | 11.2 W | 8.4 W | 10.6 W | 8.6 min | 2.8 min | 91.7 C (97.7) | 233 g | 237 g |
| A3 | 16.9 W | 12.4 W | 9.5 W | 11.8 W | 3.2 min | 0.8 min | 88.7 C (93.9) | 49 g | 53 g |
| A4 | 24.6 W | 17.3 W | 12.7 W | 17.3 W | never | 5.4 min | 75.6 C (80.2) | 233 g | 237 g |
| A5 | 25.8 W | 18.9 W | 14.5 W | 18.9 W | never | 1.3 min | 72.2 C (76.0) | 49 g | 53 g |
| B1 | 25.6 W | 17.9 W | 13.2 W | 17.9 W | never | 5.9 min | 74.3 C (79.0) | 257 g | 23 g |

Sizing (natural convection, TJ <= 80 C at TA 40 C, worst-case carrier heat): 
- A2: minimum remote/overhanging sink 374 x 272 x 20 mm fins (2446 cm^3)
- A4: minimum remote/overhanging sink 137 x 99 x 20 mm fins (326 cm^3)
- B1: minimum remote/overhanging sink 131 x 96 x 20 mm fins (301 cm^3)

## 5. Heat-pipe operating envelope (B1)

Flattened 6 mm pipe: width 8.00 mm, vapour core 6.40 x 0.90 mm (A_v 5.58 mm^2), wick 7.70 mm^2, L_total 125 mm, L_eff 85 mm. Evaporator flux 9.4 W/cm^2.

| Condition | T_v C | capillary | viscous | sonic | entrainment | boiling | governing Q_max |
|---|---|---|---|---|---|---|---|
| operating, horizontal | 70.6 | 36.4 | 3.43e+03 | 490 | 326 | 48.0 | **36.4 W (capillary)** |
| operating, 90 deg adverse | 70.6 | 32.9 | 3.43e+03 | 490 | 326 | 48.0 | **32.9 W (capillary)** |
| cold start 0 C | 0.0 | 9.4 | 2.16 | 11.4 | 59.1 | 48.0 | **2.2 W (viscous)** |
| cold start 20 C | 20.0 | 16.9 | 27.4 | 41.3 | 107 | 48.0 | **16.9 W (capillary)** |

Cold start: Q_max reaches 15 W at T_v = 16.0 C; from a 0 C soak the stalled evaporator (C = 4.8 J/K) self-heats there in 5.1 s at 15 W - far below the throttle time constant. water pipe: storage/operation below 0 C freezes the working fluid (sintered wicks tolerate freeze-thaw; cold start then follows this self-heating path).

Maximum adverse tilt (evaporator above condenser) keeping 1.5 x 15 W: **90 deg** at operating T_v; carrying 15 W from a 20 C soak: 90 deg.

## 6. Rigid-pedestal TIM tolerance stack

| Contributor | +/- mm |
|---|---|
| standoff length (module-top seat -> sink base underside) | 0.05 |
| pedestal machined height | 0.03 |
| sink base flatness under pedestal | 0.03 |
| BGA ball collapse | 0.05 |
| package substrate + die height | 0.07 |
| module PCB local bow at SoC (IPC-6012 0.75 % over 15 mm, half) | 0.06 |
| die tilt across 8 mm (coplanarity) | 0.03 |
| **Worst case / RSS** | **0.32 / 0.127** |

Gap-pad window 0.50..0.90 mm (1.0 mm pad, 10..50 % compression), nominal gap 0.70 mm, worst-case thick gap 0.83 mm, pedestal height 1.70 mm. The heat-pipe block is spring-loaded, so its phase-change BLT is independent of this stack.

## 7. Sensitivity of TJ to the unpublished SoC/heat-pipe parameters (TA 40 C, 15 W)

| Concept | base TJ | thetaJC x0.5 | thetaJC x2 | thetaJB x0.5 | thetaJB x2 | die 6x6 mm | die 10x10 mm |
|---|---|---|---|---|---|---|---|
| A3 | 93.9 | -1.1 K | +2.2 K | -3.2 K | +3.0 K | +12.0 K | -6.8 K |
| B1 | 79.0 | -1.6 K | +3.1 K | -0.4 K | +0.3 K | +1.9 K | -0.9 K |

B1 additional: R_evap x2 (0.40 K cm2/W) +1.6 K, R_cond x2 +0.3 K

## 8. Checks

| Check | Gate | Result | Detail |
|---|---|---|---|
| Rigid-pedestal TIM gap: RSS stack fits the gap-pad 10..50 % compression window | yes | PASS | stack RSS +/-0.127 mm in window 0.50..0.90 mm (nominal 0.70); 'worst TIM' columns use nominal + RSS = 0.83 mm |
| Rigid-pedestal TIM gap: arithmetic worst-case stack fits the window (info: RSS is the release criterion) | info | **FAIL** | stack WC +/-0.32 mm (RSS 0.127) vs window 0.50..0.90 mm, nominal 0.70 mm, pedestal 1.70 mm |
| Gap-pad clamp load on the SoC package at 50 % compression <= 40 N | yes | PASS | 31.5 N over 15 x 15 mm (0.14 MPa) |
| Heat-pipe evaporator spring preload <= 40 N on the package (phase-change TIM needs >= 0.1 MPa) | yes | PASS | 30 N -> 0.13 MPa |
| Recommended concept B1: mass carried by the compute module <= 60 g | yes | PASS | 23 g |
| A1: energy balance closes (|Qin - Qout| < 1 mW) at the gate corner | yes | PASS | Qin 16.013 W, Qout 16.013 W |
| A2: energy balance closes (|Qin - Qout| < 1 mW) at the gate corner | yes | PASS | Qin 16.013 W, Qout 16.013 W |
| A3: energy balance closes (|Qin - Qout| < 1 mW) at the gate corner | yes | PASS | Qin 16.013 W, Qout 16.013 W |
| A4: energy balance closes (|Qin - Qout| < 1 mW) at the gate corner | yes | PASS | Qin 16.013 W, Qout 16.013 W |
| A5: energy balance closes (|Qin - Qout| < 1 mW) at the gate corner | yes | PASS | Qin 16.013 W, Qout 16.013 W |
| B1: energy balance closes (|Qin - Qout| < 1 mW) at the gate corner | yes | PASS | Qin 16.013 W, Qout 16.013 W |
| Recommended concept B1: TJ <= 80 C (trip 85 C - 5 K) at TA 40 C, 15 W continuous, worst-case TIM | yes | PASS | TJ 79.0 C nominal / 79.0 C worst TIM |
| Recommended concept B1: TJ < critical trip 115 C at TA 50 C (no shutdown) | yes | PASS | TJ 88.8 C; sustained P at 50 C = 13.2 W before throttling |
| A1: DF40 receptacles (module PCB node) <= 85 C at every corner and load split (power capped by the 85 C governor) | info | PASS | max T_module 82.5 C at distributed, TA 50 C, P 3.4 W |
| A2: DF40 receptacles (module PCB node) <= 85 C at every corner and load split (power capped by the 85 C governor) | info | PASS | max T_module 78.7 C at distributed, TA 50 C, P 9.3 W |
| A3: DF40 receptacles (module PCB node) <= 85 C at every corner and load split (power capped by the 85 C governor) | info | PASS | max T_module 78.3 C at distributed, TA 50 C, P 10.5 W |
| A4: DF40 receptacles (module PCB node) <= 85 C at every corner and load split (power capped by the 85 C governor) | info | PASS | max T_module 84.6 C at distributed, TA 50 C, P 13.6 W |
| A5: DF40 receptacles (module PCB node) <= 85 C at every corner and load split (power capped by the 85 C governor) | info | PASS | max T_module 84.5 C at distributed, TA 50 C, P 15.0 W |
| B1: DF40 receptacles (module PCB node) <= 85 C at every corner and load split (power capped by the 85 C governor) | yes | **FAIL** | max T_module 86.3 C at distributed, TA 50 C, P 14.0 W |
| A1: SY8089 buck derated I_max at the carrier temperature >= 1.2 A budget | info | PASS | T_carrier,max 82.0 C (governed) -> I_max 1.53 A (Rev 13 115 C/W model) |
| A2: SY8089 buck derated I_max at the carrier temperature >= 1.2 A budget | info | PASS | T_carrier,max 79.1 C (governed) -> I_max 1.58 A (Rev 13 115 C/W model) |
| A3: SY8089 buck derated I_max at the carrier temperature >= 1.2 A budget | info | PASS | T_carrier,max 78.8 C (governed) -> I_max 1.59 A (Rev 13 115 C/W model) |
| A4: SY8089 buck derated I_max at the carrier temperature >= 1.2 A budget | info | PASS | T_carrier,max 83.6 C (governed) -> I_max 1.50 A (Rev 13 115 C/W model) |
| A5: SY8089 buck derated I_max at the carrier temperature >= 1.2 A budget | info | PASS | T_carrier,max 83.6 C (governed) -> I_max 1.50 A (Rev 13 115 C/W model) |
| B1: SY8089 buck derated I_max at the carrier temperature >= 1.2 A budget | yes | PASS | T_carrier,max 84.9 C (governed) -> I_max 1.47 A (Rev 13 115 C/W model) |
| B1 heat pipe: derated operating limit >= 1.5 x 15 W, horizontal, at operating vapour T | yes | PASS | 36.4 W (capillary) at T_v 70.6 C |
| B1 heat pipe: starts and carries 15 W from a 20 C cold soak (horizontal) | yes | PASS | 16.9 W (capillary) |
| B1 heat pipe: evaporator heat flux < 60 % of sintered-wick CHF (30 W/cm^2) | yes | PASS | 9.4 W/cm^2 |
| B1 heat pipe: >= 1.5x margin up to 30 deg adverse tilt (evaporator above condenser) | yes | PASS | max adverse tilt 90 deg at 22.5 W |
| B1 heat pipe routing: bend radius >= 3 D and pipe clears the M2.5 standoff circles | yes | PASS | R_bend 18 mm, min standoff clearance 9.40 mm, L_total 125 mm |

## 9. Solver self-tests

| Test | Result | Detail |
|---|---|---|
| FD solver == exact 1D slab | PASS | 2.53750 vs 2.53750 K/W |
| Spreading series vs 3D FD, src 10x10 on 40x40x3, h 2000 | PASS | series 0.5745 (R_sp 0.2530) vs FD 0.5737 K/W (+0.14 %) |
| Spreading series vs 3D FD, src 8x30 on 60x50x4, h 300 | PASS | series 1.2631 (R_sp 0.1456) vs FD 1.2644 K/W (-0.10 %) |
| Bar-Cohen S_opt = 2.714 P^-1/4 agrees with the brute-force fin-count optimum (+/-1.5 mm) | PASS | S_opt 7.10 mm vs scan 7.60 mm (16 fins, h 5.58 W/m2K) |
| Capillary limit, round 6 mm sintered, 150 mm, horizontal, 60 C in 25..80 W vendor band | PASS | 39.2 W |
| Churchill-Chu h(40 mm plate, dT 35 K) in 5..9 W/m2K | PASS | 7.53 W/m2K |
| Network energy balance (A1, distributed load) | PASS | in 15.7500 W, out 15.7500 W |
