SREESAIARJUN/radxa-cm4-nano-carrier/artifacts/rev6_df40_alignment_report.md

# Rev 6.0 - DF40 / CM4 mechanical alignment verification report

Generated by `python3 tools/cm4_mechanical.py verify` from the saved `.kicad_pcb` (pcbnew 8.0.9). Reference geometry: RPi CM4 datasheet Fig. 4, CM4IO KiCad module footprint, Radxa CM4 product brief sec. 7, Hirose DF40 catalog 2020.2.

| # | Check | Result | Detail |
|---|---|---|---|
| 1 | Board outline 55.0 x 40.0 mm | PASS | bbox 55.100 x 40.100 @ (-0.050,-0.050) |
| 2 | H1 NPTH drill 2.7 mm | PASS | drill 2.700 |
| 3 | H2 NPTH drill 2.7 mm | PASS | drill 2.700 |
| 4 | H3 NPTH drill 2.7 mm | PASS | drill 2.700 |
| 5 | H4 NPTH drill 2.7 mm | PASS | drill 2.700 |
| 6 | 4 holes coincide with CM4 hole pattern (48.0 x 33.0 pitch, 3.5 inset) | PASS | max error 0.0 um; holes [(3.5, 3.5), (3.5, 36.5), (51.5, 3.5), (51.5, 36.5)] |
| 7 | Module hole d2.6 passes M2.5 through carrier d2.7 (no interference) | PASS | d2.7 >= d2.6 |
| 8 | J1 on F.Cu, value DF40HC(3.0)-100DS-0.4V(51) | PASS | layer F.Cu, value DF40HC(3.0)-100DS-0.4V(51) |
| 9 | J1 has 100 pads | PASS | 100 pads |
| 10 | J2 on F.Cu, value DF40HC(3.0)-100DS-0.4V(51) | PASS | layer F.Cu, value DF40HC(3.0)-100DS-0.4V(51) |
| 11 | J2 has 100 pads | PASS | 100 pads |
| 12 | All 200 DF40 pad centres match CM4IO module footprint (tol 1 um) | PASS | 0 deviations |
| 13 | All 200 pads are 0.20 x 0.70 mm, long axis across the row (Hirose land) | PASS | ok |
| 14 | All 200 pad nets match CM4 pin function | PASS | ok |
| 15 | Landmarks: pin 1/101 at right (X=34.8), pin 1 outer row, pin 101 inner row, pin 102 outer row | PASS | matches datasheet Fig. 4 labelling |
| 16 | Connector centre-to-centre 33.92 mm (Rev<=5 spec said 14.8 mm: WRONG) | PASS | 33.920 mm |
| 17 | Connector centre 25.0 mm from antenna-side edge (3.5 + 21.5) | PASS | J1 X=25.0, J2 X=25.0 |
| 18 | Module rotated 180 deg cannot mate: X offset > self-alignment | PASS | 180 deg rotation shifts connector by 5.00 mm (> 0.33 mm self-align); hole pattern is symmetric so the connector offset (25.0 vs 30.0 mm) is the only mechanical key - silkscreen pin-1 + U.FL marker required |
| 19 | J1 courtyard inside board outline | PASS | (13.2, 0.65, 36.8, 5.43); min edge margin 0.65 mm |
| 20 | J1 courtyard clear of d6.2 standoff keep-outs | PASS | min gap 6.60 mm |
| 21 | J2 courtyard inside board outline | PASS | (13.2, 34.57, 36.8, 39.35); min edge margin 0.65 mm |
| 22 | J2 courtyard clear of d6.2 standoff keep-outs | PASS | min gap 6.60 mm |
| 23 | J1/J2 courtyards do not overlap | PASS |  |
| 24 | Copper-to-edge >= 0.30 mm (outer pad row) | PASS | 1.15 mm |
| 25 | Standoff keep-out fully on board (Rev 5 R1 blocker) | PASS | keep-out to edge 0.40 mm |
| 26 | Chain A: DF40 mating offset (worst case) < 0.33 mm self-alignment | PASS | WC 0.230 mm, RSS 0.097 mm, WC margin 0.100 mm |
| 27 | Chain B: M2.5 screw passes both holes (RSS < 0.15 mm radial float) | PASS | RSS 0.127 mm, WC 0.250 mm (WC exceeds float: mate module BEFORE torquing standoffs so carrier-hole float absorbs it) |
| 28 | Stack height selected allows top-side parts | PASS | DF40HC(3.0)-100DS-0.4V(51): 3.0 mm stack, 1.5 mm clearance, limit 1.2 mm |
| 29 | Pinout JSON: +5V_IN only on 77/79/81/83/85/87; 3V3 out 84/86; 1V8 out 88/90 | PASS | +5V pins [77, 79, 81, 83, 85, 87]; errors [] extra GND [] |
| 30 | Pinout JSON mechanical section == board | PASS | holes + connector pitch |
| 31 | board_outline.dxf holes == board holes | PASS | [(3.5, 3.5), (3.5, 36.5), (51.5, 3.5), (51.5, 36.5)] |
| 32 | board_outline.dxf carries all 200 pad outlines | PASS | 200 |

**32/32 checks passed.**

## Placement table (carrier frame, mm, KiCad Y-down, top view)

| Item | X | Y | Notes |
|---|---|---|---|
| H1 | 3.50 | 3.50 | NPTH d2.7, keep-out d6.2 |
| H2 | 51.50 | 3.50 | NPTH d2.7, keep-out d6.2 |
| H3 | 3.50 | 36.50 | NPTH d2.7, keep-out d6.2 |
| H4 | 51.50 | 36.50 | NPTH d2.7, keep-out d6.2 |
| J1 centre | 25.00 | 3.04 | rot 180 deg, pin 1 at (34.80, 1.50) |
| J2 centre | 25.00 | 36.96 | rot 180 deg, pin 101 at (34.80, 35.42) |

## Tolerance chains

Chain A = connector mating (module is located by the DF40 pairs; judged worst-case). Chain B = M2.5 screw fit through d2.6 module / d2.7 carrier holes (judged RSS; assembly rule: mate module first, then torque standoffs).

| Contributor | +/- mm |
|---|---|
| A: carrier DF40 placement | 0.050 |
| A: module DF40 placement | 0.050 |
| A: carrier pad artwork registration | 0.025 |
| A: module pad artwork registration | 0.025 |
| A: carrier DF40 pitch-span B half-tol (+/-0.08/2) | 0.040 |
| A: module DF40 pitch-span B half-tol | 0.040 |
| B: carrier hole drill position | 0.075 |
| B: module hole drill position | 0.075 |
| B: carrier DF40 placement (connector datum) | 0.050 |
| B: module DF40 placement (connector datum) | 0.050 |
| **Chain A worst case / RSS** | **0.230** / 0.097 (limit 0.33) |
| **Chain B worst case / RSS** | 0.250 / **0.127** (limit 0.150) |
