SREESAIARJUN/radxa-cm4-nano-carrier/artifacts/rev7_outline_drc.md

# Rev 7.0 Board Outline DRC Report

Generated by `tools/verify_outline.py`. Source of truth: `tools/board_geometry.py`.

**Overall: FAIL** (62/63 checks passed)

| ID | Check | Result | Detail |
|---|---|---|---|
| PCB-parse | kicad_pcb parses as a single S-expression | PASS |  |
| PCB-edge-only-lines | Edge.Cuts contains only the outer rectangle (no cut-outs, arcs or footprint edges) | PASS | 4 gr_line only |
| PCB-closed | PCB: Edge.Cuts forms one closed loop | PASS | 4 segments, 4 vertices, single loop |
| PCB-bbox | PCB: extents exactly (0,0)-(55.0,40.0) mm | PASS | got (0.0000,0.0000)-(55.0000,40.0000) |
| PCB-area | PCB: enclosed area = 2200.0 mm^2 (rectangular, no notches) | PASS | 2200.0000 mm^2 |
| PCB-ortho | PCB: all edges axis-aligned | PASS |  |
| HOLE-count | exactly 4 M2.5 mounting holes (H1..H4) | PASS | found ['H1', 'H2', 'H3', 'H4'] |
| HOLE-H1-pos | H1 centre at (3.50, 3.50) = 3.5 mm inset | PASS | (3.5000, 3.5000) |
| HOLE-H1-npth | H1 is NPTH, drill 2.7 mm, no annular ring | PASS | np_thru_hole drill=2.7 pad=2.7 |
| HOLE-H1-web | H1 drill wall to edge >= 1.6 mm (1x board thickness) | PASS | 2.150 mm |
| HOLE-H1-keepout | H1 Ø6.0 keep-out inside outline with >= 0.3 mm margin | PASS | 0.500 mm |
| HOLE-H1-standoff | H1 5.0 mm A/F hex standoff (any rotation) does not overhang | PASS | 0.613 mm margin (corner R 2.887) |
| HOLE-H2-pos | H2 centre at (51.50, 3.50) = 3.5 mm inset | PASS | (51.5000, 3.5000) |
| HOLE-H2-npth | H2 is NPTH, drill 2.7 mm, no annular ring | PASS | np_thru_hole drill=2.7 pad=2.7 |
| HOLE-H2-web | H2 drill wall to edge >= 1.6 mm (1x board thickness) | PASS | 2.150 mm |
| HOLE-H2-keepout | H2 Ø6.0 keep-out inside outline with >= 0.3 mm margin | PASS | 0.500 mm |
| HOLE-H2-standoff | H2 5.0 mm A/F hex standoff (any rotation) does not overhang | PASS | 0.613 mm margin (corner R 2.887) |
| HOLE-H3-pos | H3 centre at (3.50, 36.50) = 3.5 mm inset | PASS | (3.5000, 36.5000) |
| HOLE-H3-npth | H3 is NPTH, drill 2.7 mm, no annular ring | PASS | np_thru_hole drill=2.7 pad=2.7 |
| HOLE-H3-web | H3 drill wall to edge >= 1.6 mm (1x board thickness) | PASS | 2.150 mm |
| HOLE-H3-keepout | H3 Ø6.0 keep-out inside outline with >= 0.3 mm margin | PASS | 0.500 mm |
| HOLE-H3-standoff | H3 5.0 mm A/F hex standoff (any rotation) does not overhang | PASS | 0.613 mm margin (corner R 2.887) |
| HOLE-H4-pos | H4 centre at (51.50, 36.50) = 3.5 mm inset | PASS | (51.5000, 36.5000) |
| HOLE-H4-npth | H4 is NPTH, drill 2.7 mm, no annular ring | PASS | np_thru_hole drill=2.7 pad=2.7 |
| HOLE-H4-web | H4 drill wall to edge >= 1.6 mm (1x board thickness) | PASS | 2.150 mm |
| HOLE-H4-keepout | H4 Ø6.0 keep-out inside outline with >= 0.3 mm margin | PASS | 0.500 mm |
| HOLE-H4-standoff | H4 5.0 mm A/F hex standoff (any rotation) does not overhang | PASS | 0.613 mm margin (corner R 2.887) |
| HOLE-pitch | hole pitch 48.0 x 33.0 mm, rectangular pattern | PASS | 48.0000 x 33.0000 |
| KO-H1 | H1 has a Ø6.0 copper keep-out (tracks/vias/pour) on all 4 layers | PASS | layers=['F&B.Cu', 'In1.Cu', 'In2.Cu'] rules={'tracks': 'not_allowed', 'vias': 'not_allowed', 'pads': 'allowed', 'copperpour': 'not_allowed', 'footprints': 'allowed'} |
| KO-H2 | H2 has a Ø6.0 copper keep-out (tracks/vias/pour) on all 4 layers | PASS | layers=['F&B.Cu', 'In1.Cu', 'In2.Cu'] rules={'tracks': 'not_allowed', 'vias': 'not_allowed', 'pads': 'allowed', 'copperpour': 'not_allowed', 'footprints': 'allowed'} |
| KO-H3 | H3 has a Ø6.0 copper keep-out (tracks/vias/pour) on all 4 layers | PASS | layers=['F&B.Cu', 'In1.Cu', 'In2.Cu'] rules={'tracks': 'not_allowed', 'vias': 'not_allowed', 'pads': 'allowed', 'copperpour': 'not_allowed', 'footprints': 'allowed'} |
| KO-H4 | H4 has a Ø6.0 copper keep-out (tracks/vias/pour) on all 4 layers | PASS | layers=['F&B.Cu', 'In1.Cu', 'In2.Cu'] rules={'tracks': 'not_allowed', 'vias': 'not_allowed', 'pads': 'allowed', 'copperpour': 'not_allowed', 'footprints': 'allowed'} |
| OVERHANG-zero | zero overhang: every footprint/courtyard/pad/zone/track lies within 55 x 40 mm | PASS | 4 footprints, 4 zones checked |
| PCB-rev | title block revision is 7.0 | PASS | 7.0 |
| GBR-units | Edge_Cuts Gerber is metric with Profile file function | PASS |  |
| GBR-no-arcs | Edge_Cuts Gerber has no arcs (square-corner CM4 envelope) | PASS |  |
| GBR-closed | GBR: Edge.Cuts forms one closed loop | PASS | 4 segments, 4 vertices, single loop |
| GBR-bbox | GBR: extents exactly (0,0)-(55.0,40.0) mm | PASS | got (0.0000,-0.0000)-(55.0000,40.0000) |
| GBR-area | GBR: enclosed area = 2200.0 mm^2 (rectangular, no notches) | PASS | 2200.0000 mm^2 |
| GBR-ortho | GBR: all edges axis-aligned | PASS |  |
| DRL-count | Excellon drill data contains exactly 4 holes | PASS | 4 hits in ['radxa-cm4-nano-carrier-NPTH.drl', 'radxa-cm4-nano-carrier-PTH.drl'] |
| DRL-H1 | Excellon hit for H1 at (3.5, 3.5) Ø2.7 | PASS | (2.7, 3.5, 3.5) |
| DRL-H2 | Excellon hit for H2 at (51.5, 3.5) Ø2.7 | PASS | (2.7, 51.5, 3.5) |
| DRL-H3 | Excellon hit for H3 at (3.5, 36.5) Ø2.7 | PASS | (2.7, 3.5, 36.5) |
| DRL-H4 | Excellon hit for H4 at (51.5, 36.5) Ø2.7 | PASS | (2.7, 51.5, 36.5) |
| DRL-npth-file | mounting holes delivered in a dedicated NPTH drill file | PASS | radxa-cm4-nano-carrier-NPTH.drl |
| DXF-edge-only-outline | DXF EDGE_CUTS layer holds only the outer profile (no keep-out circles routed as cut-outs) | PASS | outline only |
| DXF-closed | DXF: Edge.Cuts forms one closed loop | PASS | 4 segments, 4 vertices, single loop |
| DXF-bbox | DXF: extents exactly (0,0)-(55.0,40.0) mm | PASS | got (0.0000,0.0000)-(55.0000,40.0000) |
| DXF-area | DXF: enclosed area = 2200.0 mm^2 (rectangular, no notches) | PASS | 2200.0000 mm^2 |
| DXF-ortho | DXF: all edges axis-aligned | PASS |  |
| DXF-H1 | DXF HOLES_NPTH circle for H1 (Ø2.7) | PASS | ok |
| DXF-H2 | DXF HOLES_NPTH circle for H2 (Ø2.7) | PASS | ok |
| DXF-H3 | DXF HOLES_NPTH circle for H3 (Ø2.7) | PASS | ok |
| DXF-H4 | DXF HOLES_NPTH circle for H4 (Ø2.7) | PASS | ok |
| DXF-hole-count | DXF has exactly 4 NPTH hole circles | PASS | 4 |
| DXF-overhang | no DXF geometry (keep-outs, connectors, components) outside the outline | PASS | ok |
| KICAD-drc | kicad-cli DRC (all severities, custom .kicad_dru) reports 0 violations | **FAIL** | lib_footprint_issues: The current configuration does not include the library 'CM4Carrier'.; lib_footprint_issues: The current configuration does not include the library 'CM4Carrier'.; lib_footprint_issues: The current configuration does not include the library 'CM4Carrier'.; lib_footprint_issues: The current configuration does not include the library 'CM4Carrier'. |
| KICAD-parity | schematic <-> PCB parity clean | PASS | 0 parity, 0 unconnected |
| MUT-via_0.2_mm_from_edge | mutation caught: via 0.2 mm from edge -> copper_edge_clearance | PASS | DRC types: ['copper_edge_clearance', 'lib_footprint_issues', 'via_dangling'] |
| MUT-via_inside_H1_keep-out | mutation caught: via inside H1 keep-out -> items_not_allowed | PASS | DRC types: ['items_not_allowed', 'lib_footprint_issues', 'via_dangling'] |
| MUT-H1_moved_to_legacy_2.25_mm_inset | mutation caught: H1 moved to legacy 2.25 mm inset -> npth_edge_web (hole_clearance) | PASS | DRC types: ['hole_clearance', 'lib_footprint_issues'] |
| MUT-Edge.Cuts_corner_opened | mutation caught: Edge.Cuts corner opened -> invalid_outline | PASS | DRC types: ['invalid_outline', 'lib_footprint_issues'] |
