SREESAIARJUN/radxa-cm4-nano-carrier/artifacts/iteration_3_opus_schematic.md

# Radxa CM4 Nano Carrier Board, Rev 3.0: Hardware Design Document

**Document status:** Engineering draft. Do not release to fabrication until the Design Review Findings in Section 0 are closed.

---

## 0. Design Review Findings (Read First)

Several input requirements conflict with physical, electrical or vendor facts. They are listed here so they are not buried in the detailed sections.

| # | Finding | Severity | Required action |
|---|---|---|---|
| F1 | **Mounting holes do not match the CM4 form factor.** RPi CM4, Radxa CM3 and Radxa CM5 modules use holes inset 3.5 mm, at a pitch of
