SREESAIARJUN/radxa-cm4-nano-carrier/artifacts/iteration_10_fast_drc.md

# DRC Review: 55 × 40 mm Board (Revision Under Review)

## Status: Blocked. No design data was received

Your message references "the latest engineering iteration from Claude Opus 5.5," but nothing came through after the colon. I have no Gerbers, ODB++, IPC-2581, native CAD files, BOM, placement file, or stackup. I also can't see output from any other model or tool.

I won't invent coordinates, clearances, or violations for a layout I haven't seen. Doing so would produce a fabricated sign-off, which is worse than no review.

What I can do now:
1. Report findings that follow directly from the constraints you stated. Some of these are real issues regardless of the layout.
2. Give you a numerical pass/fail rule deck to apply when the files arrive.
3. List the files I need to complete the review.

---

## 1. Findings from your stated constraints

### 1.1 Mounting holes: the
