SREESAIARJUN/radxa-cm4-nano-carrier/artifacts/iteration_13_fast_drc.md

# DRC Review: 55.0 × 40.0 mm Board

## Status: Review Blocked, No Design Data Received

The request references "the latest engineering iteration," but no layout data was included. There are no Gerbers, ODB++, placement file, stackup, or netlist. **I can't issue PASS/FAIL results without the actual design.** Inventing clearances or skew numbers would produce a false sign-off, which is worse than no review.

What I can do now is:
1. Flag problems already visible in the stated constraints.
2. Give the numerical pass/fail criteria the layout will be judged against, so the next upload can be checked line by line.

---

## 1. Issues Visible in the Specification Itself

### ⚠️ Flag A: The M2.5 mounting-hole margin is ambiguous and possibly unbuildable

"2.25 mm margin" has two readings with very different outcomes:

| Interpretation | Hole center from edges | Result |
|---|---|---|
| (a) Hole **center** at 2.25 mm | (2.25, 2.25) | **FAIL.** A 2.7 mm clearance hole leaves 0.90 mm of FR4 to the edge. A standard M2.5 standoff (5.0 mm across flats, ~5.8 mm across corners) or a Ø5.0 mm keepout ring overhangs the board edge by about 0.25–0.65 mm. |
| (b) 2.25 mm from hole **edge** to board edge | (3.60, 3.60) | **Workable.** A Ø5.0 mm head keepout sits 1.1 mm inside the edge. A Ø6.0 mm keepout sits 0.6 mm inside. |

**Correction:** Place hole centers at **(3.60, 3
