SREESAIARJUN/radxa-cm4-nano-carrier/artifacts/iteration_7_fast_drc.md

# DRC Review: 55.0 × 40.0 mm Carrier Board

## Status: Design Data Missing, No Verdict Issued

The design files did not come through. Your message ends after "Review the latest engineering iteration," with no placement file, Gerbers, ODB++, IPC-2581, netlist, stackup, or screenshots attached.

I won't issue pass/fail results without the data, because invented results would be worse than none. Below are:

- **Part A:** findings that follow from the constraints you stated
- **Part B:** the DRC criteria I will apply once the data arrives
- **Part C:** the files I need

---

## Part A: Findings From the Stated Constraints

### A1. Mounting Hole Geometry (M2.5 at 2.25 mm margins)

Hole centers: (2.25, 2.25), (52.75, 2.25), (2.25, 37.75), (52.75, 37.75).

| Check | Value | Result |
|---|---|---|
| Hole wall to board edge (2.7 mm drill, ISO 273 fine) | 2.25 − 1.35 = **0.90 mm** | PASS for fabrication (typical minimum 0.5 mm) |
| Hole wall to board edge (2.9 mm drill, medium) | 2.25 − 1.45 = **0.80 mm** | PASS |
| M2.5 pan head / ISO 7089 washer (Ø5.0 mm)
