SREESAIARJUN/radxa-cm4-nano-carrier/artifacts/iteration_8_fast_drc.md

# DRC Review: 55.0 × 40.0 mm Board

## Status: Review Blocked, No Design Data Received

Your message references "the latest engineering iteration," but no design content was attached. There is no placement file, netlist, Gerbers/ODB++, stackup, or board file (KiCad, Altium, etc.). I can't issue pass/fail results on a layout I haven't seen, and inventing results would be worse than none.

Below is what I *can* do now: a pre-computed rule deck derived from your stated constraints, a few constraint-level findings that apply to any layout with these specs, and the exact data I need to complete the review.

---

## 1. Board Envelope and M2.5 Mounting Holes

### Ambiguity to resolve first
"2.25 mm margins" can mean two different things:

| Interpretation | Hole center from edges | Hole edge to board edge (Ø2.7 clearance hole) |
|---|---|---|
| A: center at 2.25 mm | (2.25, 2.25) | 0.90 mm |
| B: hole edge at 2.25 mm | (3.60, 3.60) | 2.25 mm |

### ⚠️ Constraint-level finding (Interpretation A)
- An ISO 7045 M2.5 pan head is about Ø5.0 mm (r = 2.5 mm). Centered 2.25 mm from the edge, **it overhangs the board edge by 0.25 mm**.
- A 5 mm AF hex standoff is about 5.77 mm across corners (r ≈ 2.89 mm). **It overhangs by up to 0.64 mm.**
- This fails if the board s
