SREESAIARJUN/radxa-cm4-nano-carrier/artifacts/rev9_mdi_layout.png

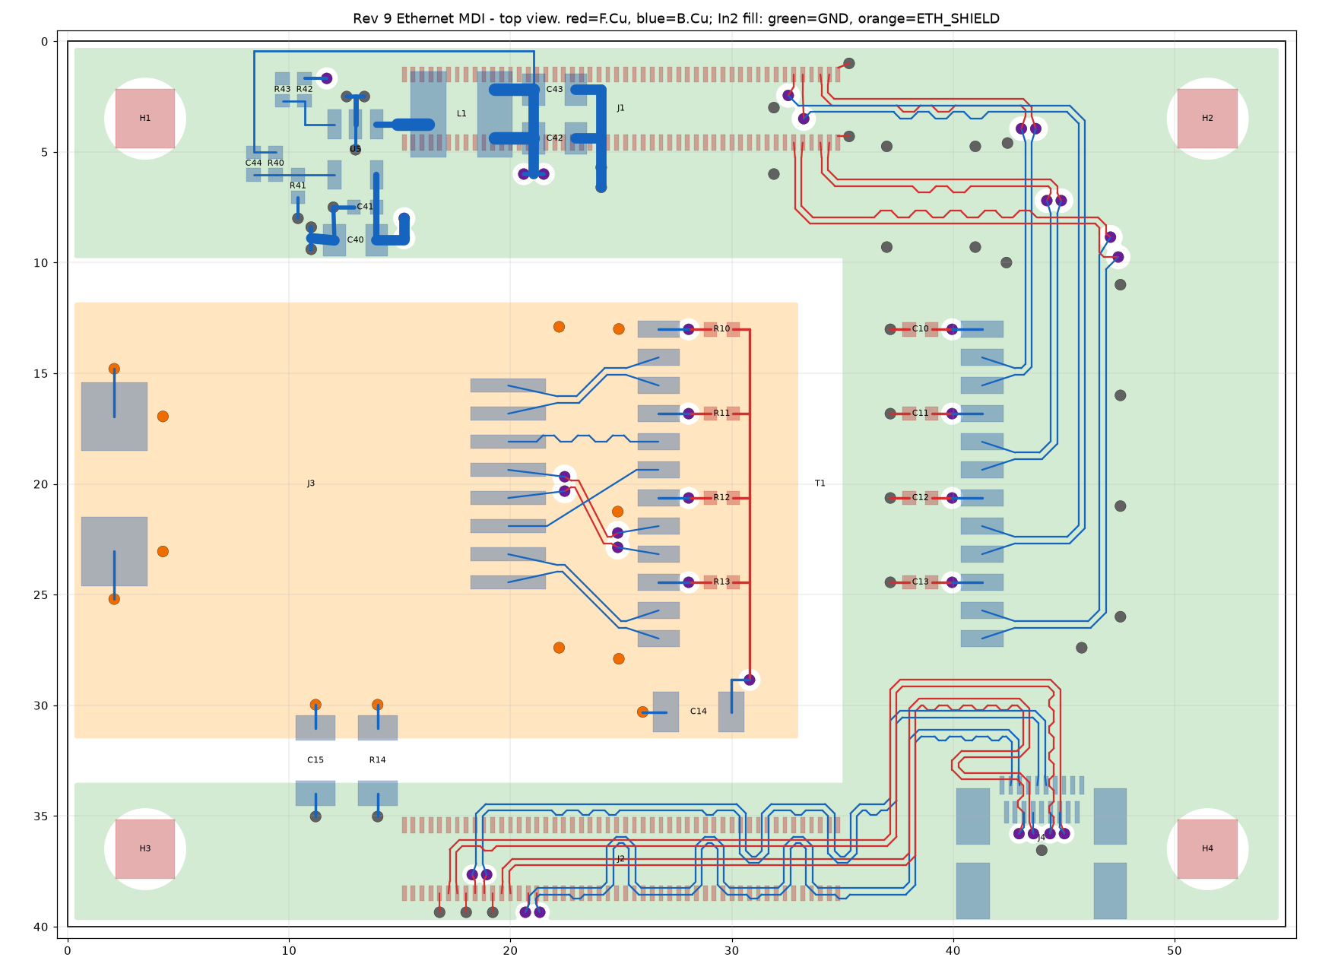
artifacts/rev9_mdi_layout.png
