SREESAIARJUN/radxa-cm4-nano-carrier/artifacts/rev13_buck_layout.png

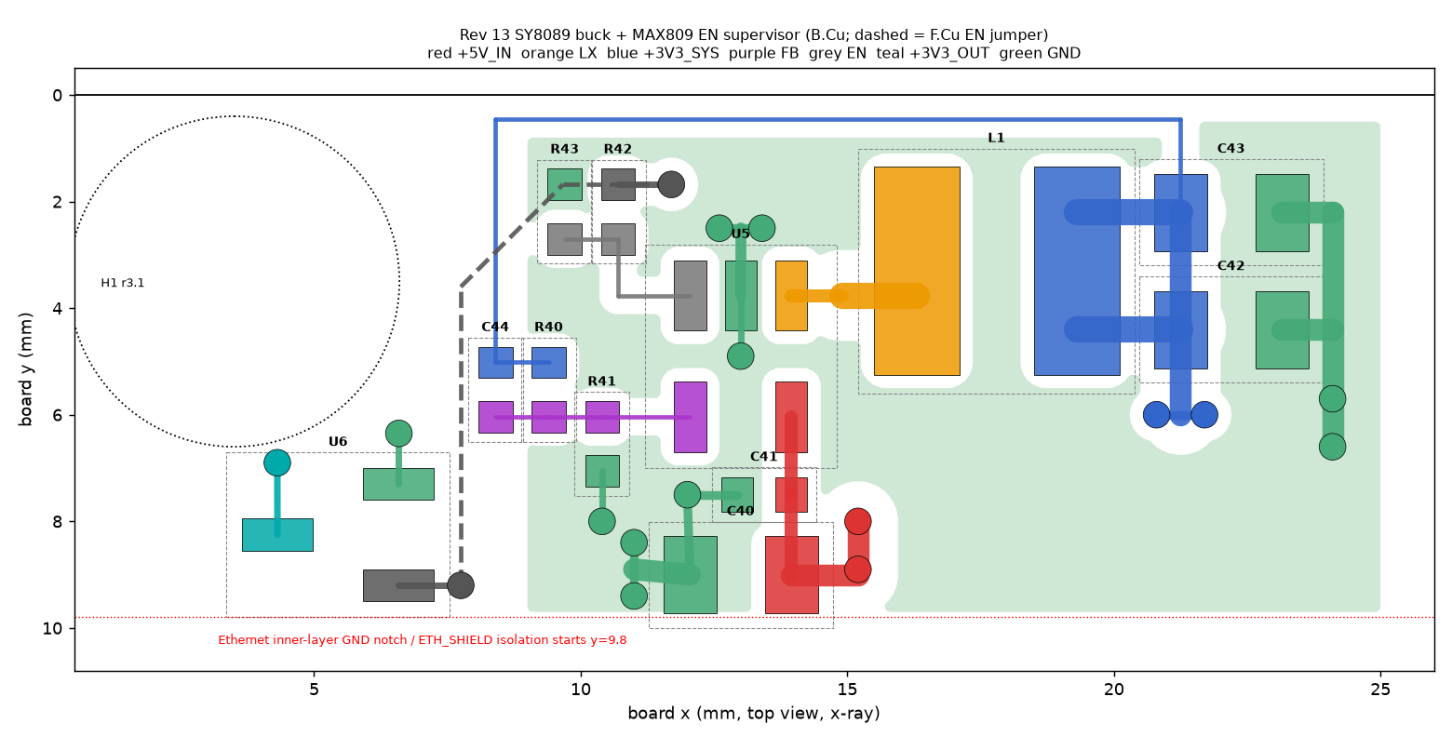
artifacts/rev13_buck_layout.png
