SREESAIARJUN/radxa-cm4-nano-carrier/artifacts/rev17_power_seq_layout.png

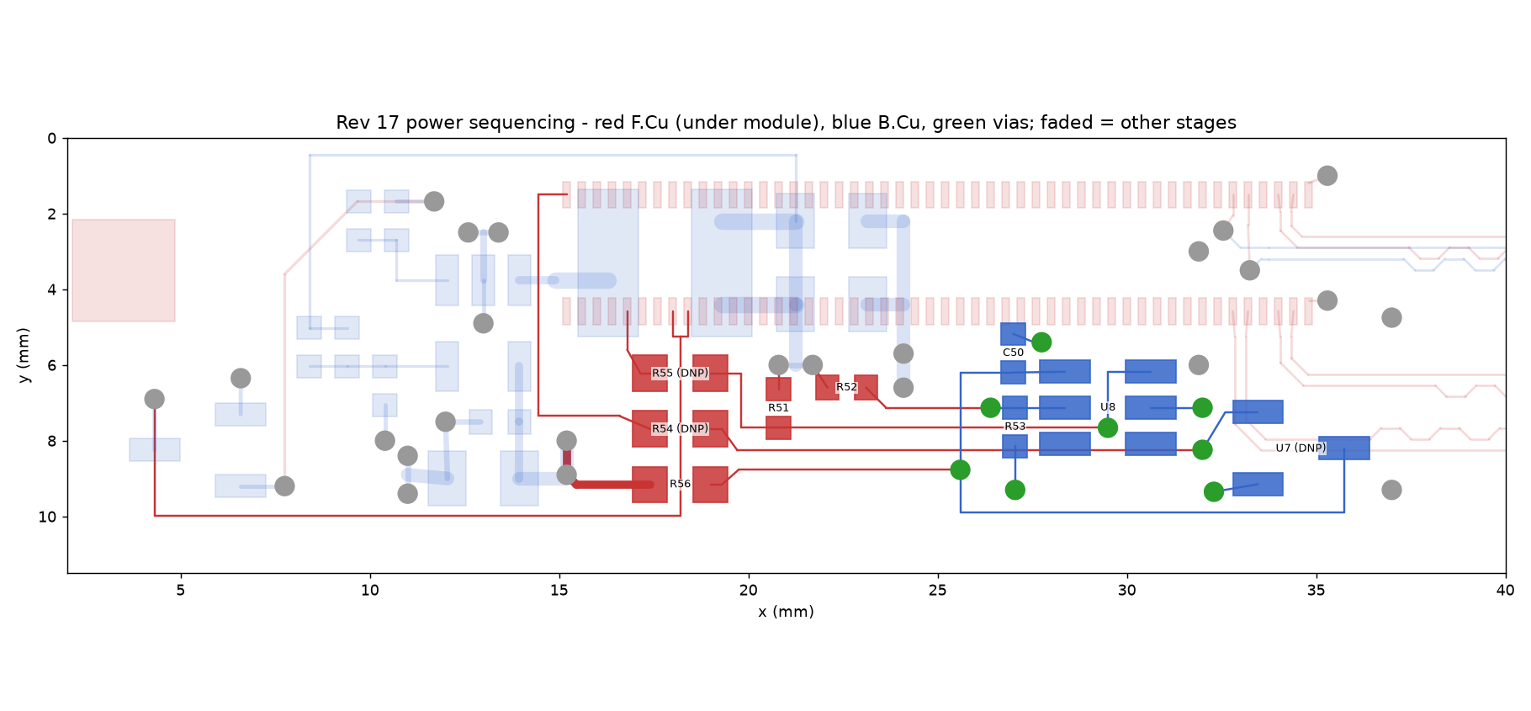
artifacts/rev17_power_seq_layout.png
