SREESAIARJUN/radxa-cm4-nano-carrier/stl/rev15_heatpipe_assembly.stl

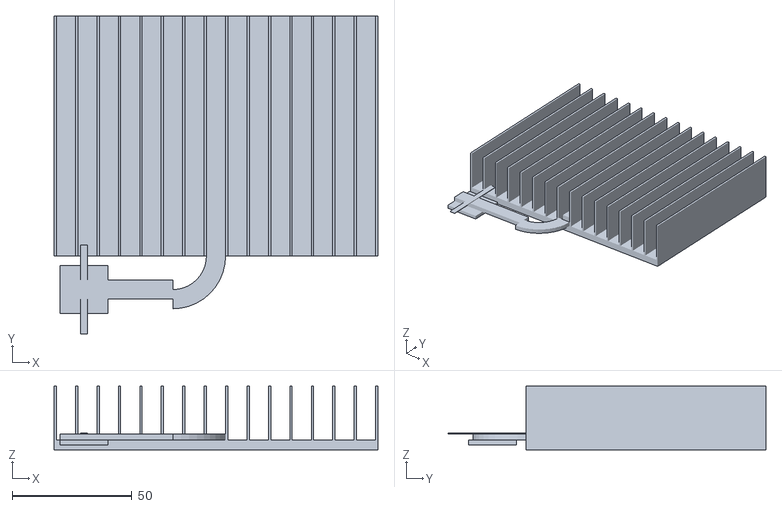
[picture p4: CAD file, 2026-11-06]
stl/rev15_heatpipe_assembly.stl
135.0 x 132.5 x 26.5
