SREESAIARJUN/radxa-cm4-nano-carrier/board_outline.dxf

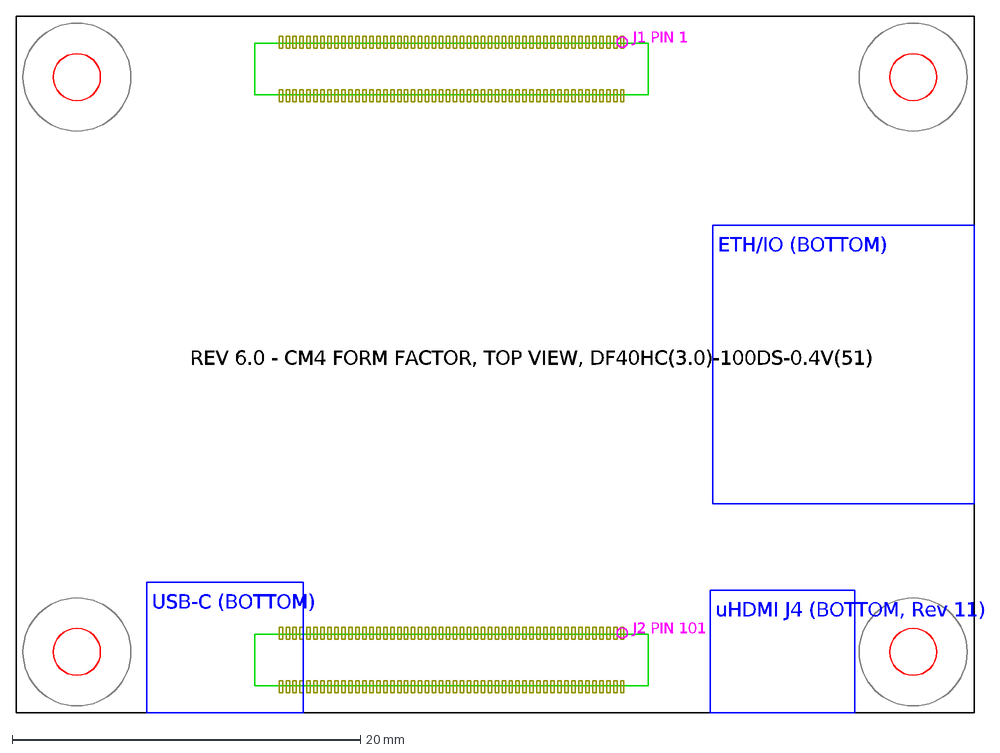
[picture p5: CAD file, 2026-11-06]
board_outline.dxf
J1 PIN 1
J2 PIN 101
USB-C (BOTTOM)
uHDMI J4 (BOTTOM, Rev 11)
ETH/IO (BOTTOM)
REV 6.0 - CM4 FORM FACTOR, TOP VIEW, DF40HC(3.0)-100DS-0.4V(51)
