SREESAIARJUN/radxa-cm4-nano-carrier/stl/rev15_thermal_concepts.stl

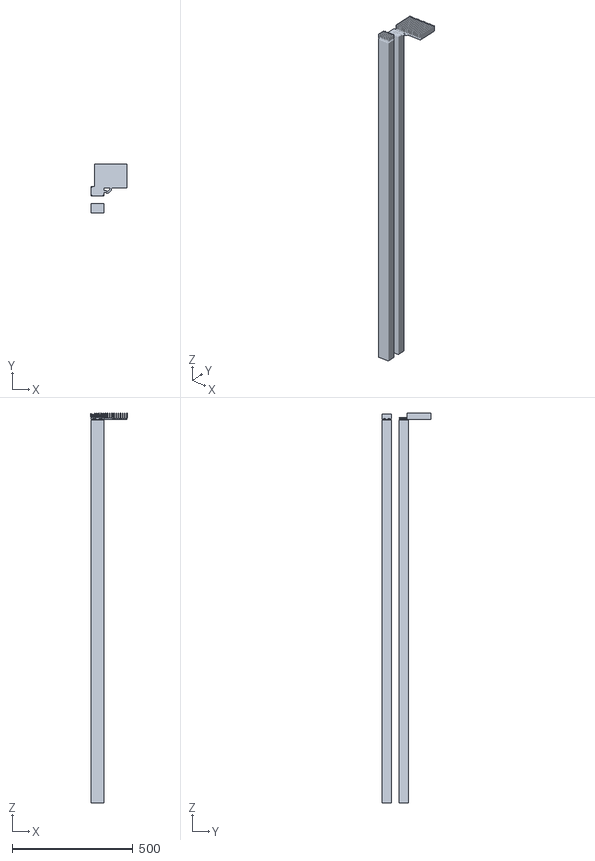
[picture p6: CAD file, 2026-11-06]
stl/rev15_thermal_concepts.stl
150.0 x 204.0 x 1616.0
