SREESAIARJUN/radxa-cm4-nano-carrier/stl/rev15_pedestal_sink.stl

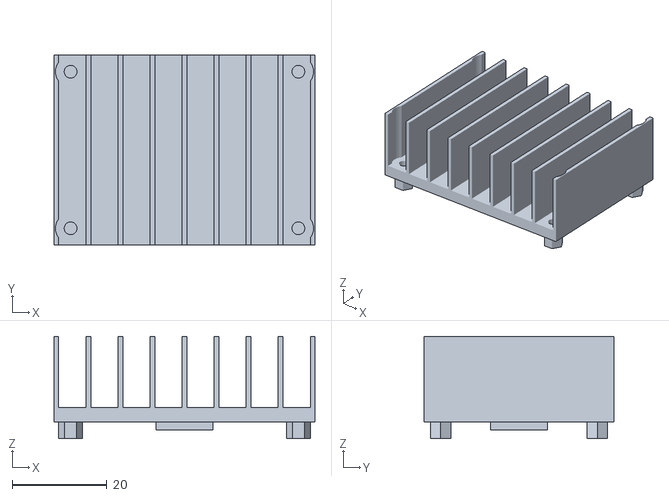
[picture p7: CAD file, 2026-11-06]
stl/rev15_pedestal_sink.stl
55.0 x 40.0 x 21.5
