SREESAIARJUN/radxa-cm4-nano-carrier/artifacts/outline_v14.dxf

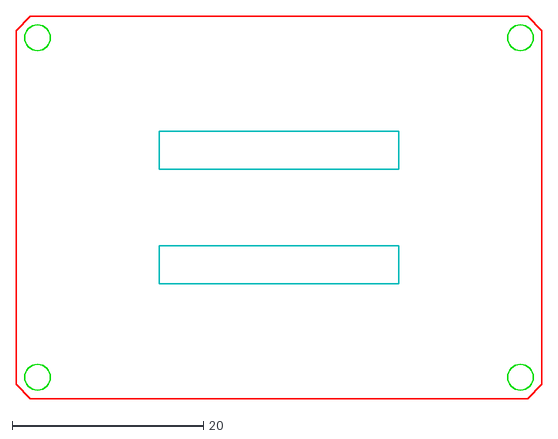
[picture p8: CAD file, 2026-11-05]
artifacts/outline_v14.dxf
55.0 x 40.0
