SREESAIARJUN/radxa-cm4-nano-carrier/artifacts/outline_v5.dxf

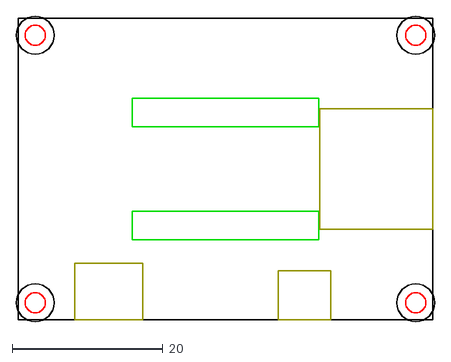
[picture p10: CAD file, 2026-11-05, an earlier design]
artifacts/outline_v5.dxf
55.5 x 40.5
