SREESAIARJUN/radxa-cm4-nano-carrier/artifacts/outline_v8.dxf

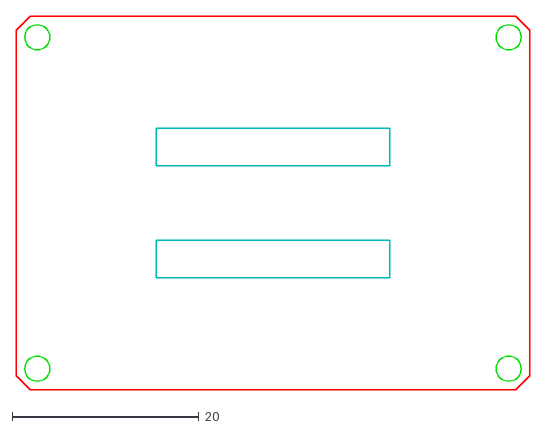
[picture p17: CAD file, 2026-11-05, an earlier design]
artifacts/outline_v8.dxf
55.0 x 40.0
