SREESAIARJUN/radxa-cm4-nano-carrier/artifacts/outline_v12.dxf

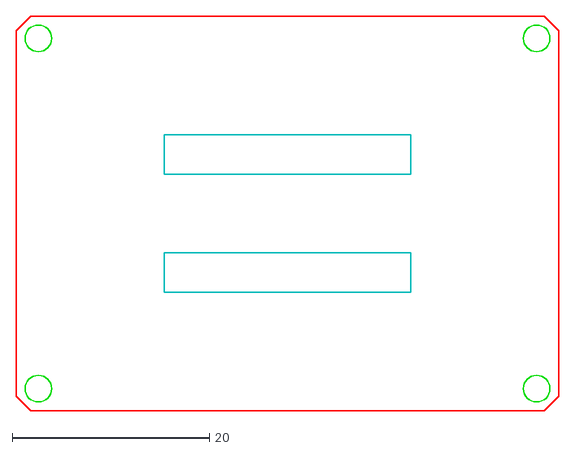
[picture p19: CAD file, 2026-11-05, an earlier design]
artifacts/outline_v12.dxf
55.0 x 40.0
