SREESAIARJUN/radxa-cm4-nano-carrier/artifacts/outline_v9.dxf

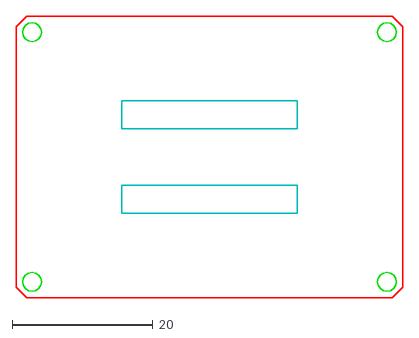
[picture p20: CAD file, 2026-11-05, an earlier design]
artifacts/outline_v9.dxf
55.0 x 40.0
