SREESAIARJUN/radxa-cm4-nano-carrier/cad/rev15_thermal_concepts.scad

// Rev 15 thermal concepts - GENERATED by tools/thermal_15w.py cad (do not hand-edit)
// Units mm. Carrier frame (X 0..55, Y 0..40, Y as KiCad but Z up from carrier top).
// Render:  openscad -D 'part="pedestal"' -o stl/rev15_pedestal_sink.stl cad/rev15_thermal_concepts.scad
//          openscad -D 'part="heatpipe"' -o stl/rev15_heatpipe_assembly.stl cad/rev15_thermal_concepts.scad
part = "both";                      // pedestal | heatpipe | stack | both
$fn = 40;
BOARD = [55.0, 40.0];
HOLES = [[3.50,3.50], [51.50,3.50], [3.50,36.50], [51.50,36.50]];
CAR_T = 1586.200;
STACK_H = 3.00;
MOD_T = 1.20;
SOC_C = [27.5, 20.0];
SOC_PKG = [15.0, 15.0];
SOC_TOP = 1.10;
DIE = [8.0, 8.0];
// --- concept A (rigid integral pedestal)
BASE_CLR = 3.50;       // sink-base underside above module PCB top
PED_TIP = [12.0, 12.0];
PED_H = 1.700;                // = BASE_CLR - SOC_TOP - nominal gap-pad gap
GAP_NOM = 0.700;
A_TB = 3.0; A_H = 15.0; A_TF = 1.0; A_N = 9;
// --- concept B (heat pipe)
BLK = [20.0, 20.0, 2.0];
HP_W = 7.998; HP_T = 2.50;
HP_LA = 45.0; HP_LC = 60.0; HP_RB = 18.0;
R_W = 135.0; R_L = 100.0; R_TB = 4.0;
R_H = 20.0; R_TF = 1.0; R_N = 16;

module_top = CAR_T + STACK_H + MOD_T;

module stack() {
    color("green") difference() { cube([BOARD[0], BOARD[1], CAR_T]);
        for (h = HOLES) translate([h[0], h[1], -1]) cylinder(d = 2.7, h = CAR_T + 2); }
    color("darkgreen") translate([0, 0, CAR_T + STACK_H]) difference() { cube([BOARD[0], BOARD[1], MOD_T]);
        for (h = HOLES) translate([h[0], h[1], -1]) cylinder(d = 2.6, h = MOD_T + 2); }
    color("black") translate([SOC_C[0] - SOC_PKG[0]/2, SOC_C[1] - SOC_PKG[1]/2, module_top])
        cube([SOC_PKG[0], SOC_PKG[1], SOC_TOP]);
}

module fins(w, l, tb, h, tf, n) {
    s = (w - n * tf) / (n - 1);
    cube([w, l, tb]);
    for (i = [0 : n - 1]) translate([i * (tf + s), 0, tb]) cube([tf, l, h]);
}

module pedestal_sink() {
    z0 = module_top + BASE_CLR;
    difference() {
        union() {
            translate([0, 0, z0]) fins(BOARD[0], BOARD[1], A_TB, A_H, A_TF, A_N);
            translate([SOC_C[0] - PED_TIP[0]/2, SOC_C[1] - PED_TIP[1]/2, z0 - PED_H]) cube([PED_TIP[0], PED_TIP[1], PED_H + 0.01]);
        }
        for (h = HOLES) translate([h[0], h[1], z0 - 1]) cylinder(d = 2.7, h = A_TB + A_H + 2);   // M2.5 clearance
        for (h = HOLES) translate([h[0], h[1], z0 + A_TB]) cylinder(d = 6.4, h = A_H + 1);      // driver access
    }
    color("grey") for (h = HOLES) translate([h[0], h[1], module_top]) cylinder(d = 5.0, h = BASE_CLR, $fn = 6);
}

module heatpipe_assembly() {
    zb = module_top + SOC_TOP + 0.03;
    color("orange") translate([SOC_C[0] - BLK[0]/2, SOC_C[1] - BLK[1]/2, zb]) cube(BLK);
    // flattened pipe: evaporator over the block, +X run to the board edge, 90 deg bend, condenser along the sink
    zp = zb + BLK[2];
    color("peru") {
        translate([SOC_C[0] - BLK[0]/2, SOC_C[1] - HP_W/2, zp]) cube([BLK[0] + HP_LA - HP_RB, HP_W, HP_T]);
        translate([SOC_C[0] + BLK[0]/2 + HP_LA - HP_RB, SOC_C[1] + HP_RB - HP_W/2, zp])
            rotate([0, 0, -90]) rotate_extrude(angle = 90) translate([HP_RB - HP_W/2, 0]) square([HP_W, HP_T]);
        translate([SOC_C[0] + BLK[0]/2 + HP_LA - HP_W/2, SOC_C[1] + HP_RB, zp]) cube([HP_W, HP_LC, HP_T]);
    }
    // remote sink: base under the condenser run, fins up
    translate([SOC_C[0] + BLK[0]/2 + HP_LA - R_W/2, SOC_C[1] + HP_RB - 4, zp - R_TB]) {
        fins(R_W, R_L, R_TB, R_H + HP_T, R_TF, R_N);
    }
    // spring clip bar across the block, anchored on the two +X standoffs
    color("silver") translate([SOC_C[0] - 1.5, 3.5 - 2, zp + HP_T]) cube([3, BOARD[1] - 3, 0.6]);
}

if (part == "pedestal") pedestal_sink();
else if (part == "heatpipe") heatpipe_assembly();
else if (part == "stack") stack();
else { stack(); pedestal_sink(); translate([0, 70, 0]) { stack(); heatpipe_assembly(); } }
