SREESAIARJUN/radxa-cm4-nano-carrier/(list of files, cad)

Other CAD files:
artifacts/outline_v7.dxf
