SREESAIARJUN/radxa-cm4-nano-carrier/radxa-cm4-nano-carrier.kicad_pcb

## KiCad design radxa-cm4-nano-carrier.kicad_pcb (2026-11-06)

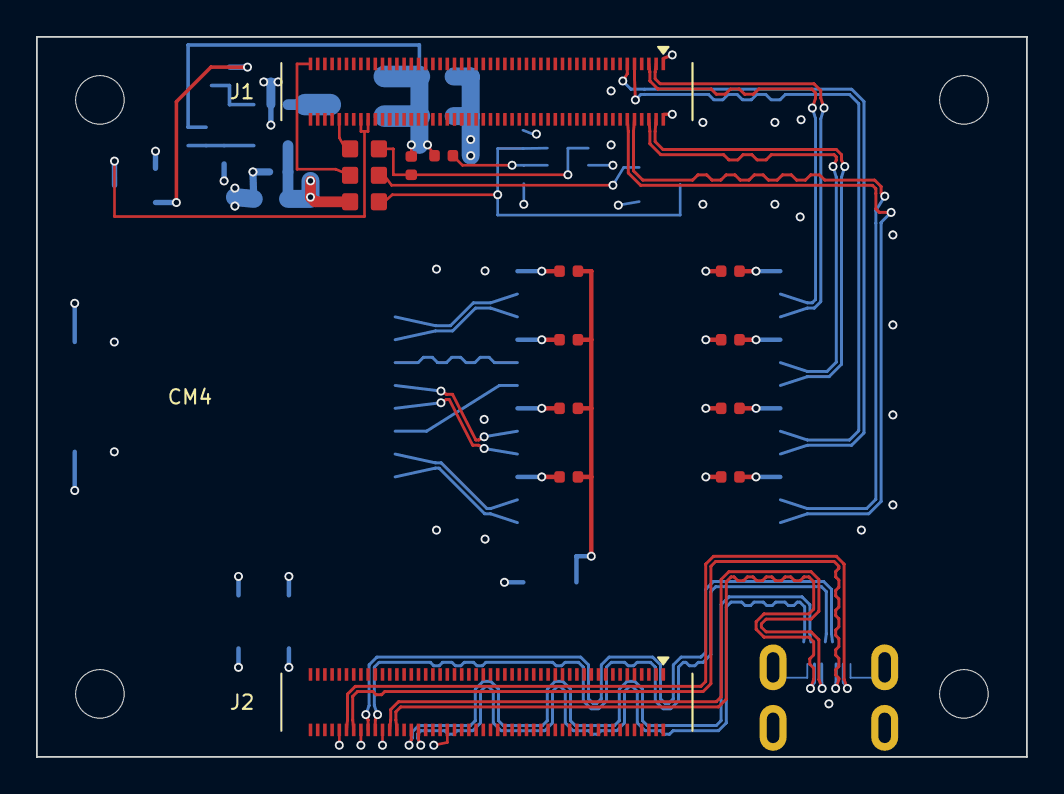
[picture p21: board radxa-cm4-nano-carrier.kicad_pcb from above]

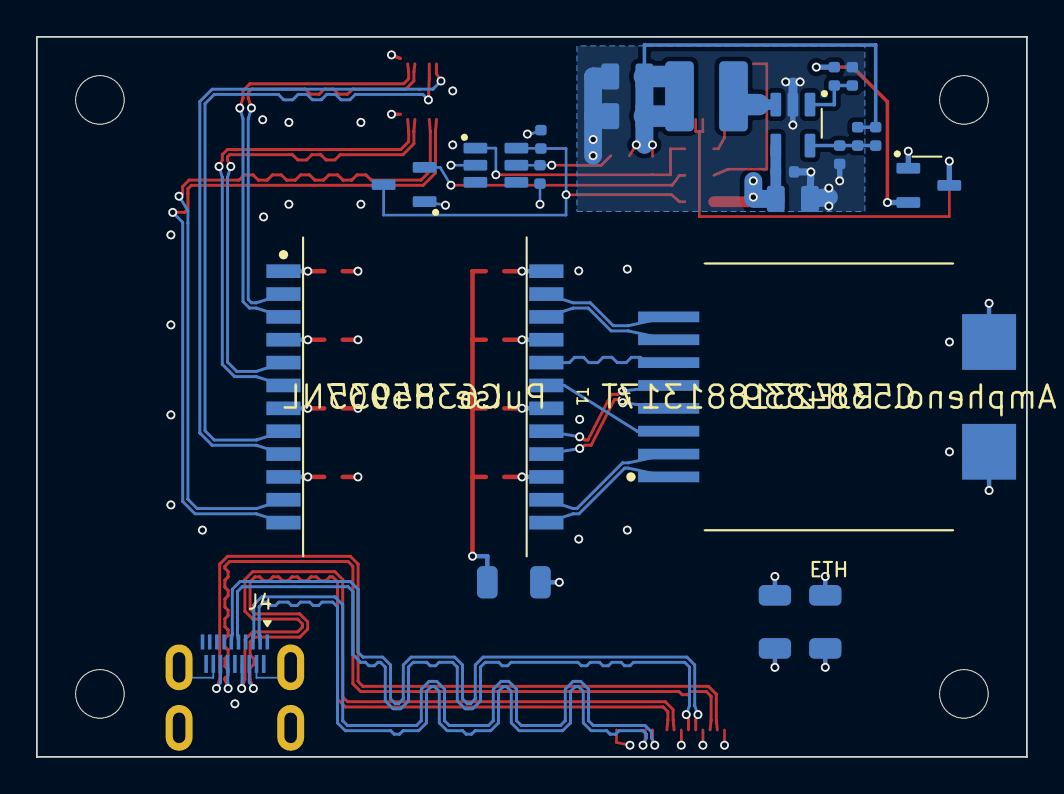
[picture p22: board radxa-cm4-nano-carrier.kicad_pcb from below]

Board: 4 copper layers, 55.0 x 40.0 mm, 41 parts (22 on the bottom side), 53 nets.

Parts:
C10, C11, C12, C13, C41, C50: 100nF 16V X7R; C_0402_1005Metric
C14, C15: 1nF 2kV X7R; C_1206_3216Metric_HV
C40, C42, C43: 22uF 25V X5R; C_0805_2012Metric
C44: 47pF 50V C0G; C_0402_1005Metric
H1, H2, H3, H4: M2.5 x 3.0 mm standoff; MountingHole_2.7mm_M2.5_CM4
J1, J2: DF40HC(3.0)-100DS-0.4V(51); Hirose_DF40HC-3.0-100DS-0.4V_2x50_P0.4mm
J3: RJE231881317T; Amphenol_RJE231881317T_RJ45_Vertical_SMD
J4: HDMI-101S; HDMI_Micro-D_XUNPU_HDMI-101S
L1: 2.2uH 5.8A 39mR; L_4.0x4.0mm_cjiang_FNR4030
R10, R11, R12, R13: 75R 1%; R_0402_1005Metric
R14: 1M 1206; R_1206_3216Metric
R40: 100k 0.1% 25ppm; R_0402_1005Metric
R41: 22.1k 0.1% 25ppm; R_0402_1005Metric
R42, R53: 10k 1%; R_0402_1005Metric
R43: 1M 1%; R_0402_1005Metric
R51: 100k 1% (RADXA only); R_0402_1005Metric
R52: 61.9k 1%; R_0402_1005Metric
R54: 0R 0603 (RPI_CM4 only); R_0603_1608Metric_Bridge
R55: 220R 1% 0603 (RPI_CM4 only); R_0603_1608Metric_Bridge
R56: 10R 1% 0603; R_0603_1608Metric_Bridge
T1: H5007NL; Pulse_H5007NL_SMD-24_P1.27mm
U5: SY8089AAAC; SOT-23-5_Silergy_SY8089
U6: MAX809STRG 2.93V; SOT-23_onsemi_MAX809
U7: MIC803-44D3VM3-TR (RPI_CM4 only); SOT-23_Microchip_MIC803
U8: TPS3808G01DBVR; SOT-23-6_TI_DBV_TPS3808

Connections:
+1V8_OUT: J1.88, J1.90
+3V3_OUT: J1.84, J1.86, U6.3
+3V3_SYS: C42.1, C43.1, C44.2, L1.2, R40.2, R51.1, R52.1
+5V_IN: C40.1, C41.1, J1.77, J1.79, J1.81, J1.83, J1.85, J1.87, R56.1, U5.4
BUCK_EN: R42.1, R43.1, U5.1
BUCK_EN_SRC: R42.2, U6.2
BUCK_FB: C44.1, R40.1, R41.1, U5.5
BUCK_LX: L1.1, U5.3
ETH_BS: C14.2, R10.2, R11.2, R12.2, R13.2
ETH_MCT1: R10.1, T1.24
ETH_MCT2: R11.1, T1.21
ETH_MCT3: R12.1, T1.18
ETH_MCT4: R13.1, T1.15
ETH_MDI0_N: J3.2, T1.14
ETH_MDI0_P: J3.1, T1.13
ETH_MDI1_N: J3.6, T1.20
ETH_MDI1_P: J3.3, T1.19
ETH_MDI2_N: J3.5, T1.17
ETH_MDI2_P: J3.4, T1.16
ETH_MDI3_N: J3.8, T1.23
ETH_MDI3_P: J3.7, T1.22
ETH_SHIELD: C14.1, C15.2, J3.M1, J3.M2, R14.2
ETH_TCT1: C10.2, T1.1
ETH_TCT2: C11.2, T1.4
ETH_TCT3: C12.2, T1.7
ETH_TCT4: C13.2, T1.10
Ethernet_Pair0_N: J1.10, T1.11
Ethernet_Pair0_P: J1.12, T1.12
Ethernet_Pair1_N: J1.6, T1.5
Ethernet_Pair1_P: J1.4, T1.6
Ethernet_Pair2_N: J1.9, T1.8
Ethernet_Pair2_P: J1.11, T1.9
Ethernet_Pair3_N: J1.5, T1.2
Ethernet_Pair3_P: J1.3, T1.3
GLOBAL_EN: J1.99, R54.1
GND: C10.1, C11.1, C12.1, C13.1, C15.1, C40.2, C41.2, C42.2, C43.2, C50.2, J1.1, J1.2, J1.7, J1.8, J1.13, J1.14, J1.22, J1.23, J1.32, J1.33, J1.42, J1.43, J1.52, J1.53, J1.59, J1.60, J1.65, J1.66, J1.71, J1.74, J1.98, J2.7, J2.8, J2.13, J2.14, J2.19, J2.20, J2.25, J2.26, J2.31, J2.32, J2.37, J2.38, J2.44, J2.50, J2.55, J2.56, J2.61, J2.62, J2.67, J2.68, J2.73, J2.74, J2.79, J2.80, J2.85, J2.86, J2.91, J2.92, J2.97, J2.98, J4.4, J4.7, J4.10, J4.13, J4.16, J4.20, R14.1, R41.2, R43.2, R53.2, U5.2, U6.1, U7.1, U8.2
HDMI0_CEC: J2.51, J4.15
HDMI0_CLK_N: J2.90, J4.14
HDMI0_CLK_P: J2.88, J4.12
HDMI0_HOTPLUG: J2.53, J4.1
HDMI0_SCL: J2.100, J4.17
HDMI0_SDA: J2.99, J4.18
HDMI0_TX0_N: J2.84, J4.11
HDMI0_TX0_P: J2.82, J4.9
HDMI0_TX1_N: J2.78, J4.8
HDMI0_TX1_P: J2.76, J4.6
HDMI0_TX2_N: J2.72, J4.5
HDMI0_TX2_P: J2.70, J4.3
PSEQ_PWR_OK: R51.2, R55.2, U8.1
PSEQ_SENSE_3V3: R52.2, R53.1, U8.5
PSEQ_VDD: C50.1, R56.2, U7.3, U8.6
PSEQ_VIN_OK: R54.2, U7.2
RUN_PG: J1.92, R55.1
