SREESAIARJUN/radxa-cm4-nano-carrier/tools/verify_outline.py

#!/usr/bin/env python3
"""Rev 7 board-outline DRC: zero-overhang Edge.Cuts + M2.5 mounting-hole audit.

Checks every manufacturing representation of the board envelope against the
single source of truth in tools/board_geometry.py:

  * radxa-cm4-nano-carrier.kicad_pcb  (Edge.Cuts, holes, keep-outs, overhang)
  * gerbers/*-Edge_Cuts.gm1            (profile as sent to the fab)
  * gerbers/*.drl                      (NPTH drill hits as sent to the fab)
  * board_outline.dxf                  (enclosure / mechanical hand-off)
  * kicad-cli DRC (+ mutation tests proving the .kicad_dru rules fire)

Usage:  python3 tools/verify_outline.py [--no-kicad] [--report artifacts/rev7_outline_drc.md]
Exit status is non-zero if any check fails.
"""
from __future__ import annotations

import argparse
import json
import math
import re
import shutil
import subprocess
import sys
import tempfile
from dataclasses import dataclass, field
from pathlib import Path

sys.path.insert(0, str(Path(__file__).resolve().parent))
import board_geometry as G  # noqa: E402

ROOT = Path(__file__).resolve().parent.parent
PCB = ROOT / "radxa-cm4-nano-carrier.kicad_pcb"
GERBER_EDGE = ROOT / "gerbers" / "radxa-cm4-nano-carrier-Edge_Cuts.gm1"
DRILL_FILES = sorted((ROOT / "gerbers").glob("*.drl"))
DXF = ROOT / "board_outline.dxf"
MOUNT_LIB_ID = "CM4Carrier:MountingHole_M2.5_NPTH_KO6"


# --------------------------------------------------------------------------
# Minimal S-expression reader (sufficient for KiCad 8 files)
# --------------------------------------------------------------------------
_TOKEN = re.compile(r'\s*(?:(\()|(\))|"((?:[^"\\]|\\.)*)"|([^\s()"]+))')


def parse_sexpr(text: str):
    stack: list[list] = [[]]
    pos = 0
    while pos < len(text):
        m = _TOKEN.match(text, pos)
        if not m:
            if text[pos:].strip() == "":
                break
            raise ValueError(f"S-expression parse error at offset {pos}")
        pos = m.end()
        if m.group(1):
            stack.append([])
        elif m.group(2):
            done = stack.pop()
            stack[-1].append(done)
        elif m.group(3) is not None:
            stack[-1].append(m.group(3))
        elif m.group(4) is not None:
            stack[-1].append(m.group(4))
    if len(stack) != 1:
        raise ValueError("unbalanced parentheses")
    return stack[0][0]


def children(node, name):
    return [c for c in node if isinstance(c, list) and c and c[0] == name]


def child(node, name):
    c = children(node, name)
    return c[0] if c else None


def xy(node):
    return float(node[1]), float(node[2])


# --------------------------------------------------------------------------
# Result bookkeeping
# --------------------------------------------------------------------------
@dataclass
class Check:
    cid: str
    desc: str
    ok: bool
    detail: str = ""


@dataclass
class Report:
    checks: list[Check] = field(default_factory=list)

    def add(self, cid, desc, ok, detail=""):
        self.checks.append(Check(cid, desc, bool(ok), detail))

    @property
    def ok(self):
        return all(c.ok for c in self.checks)


def close(a, b, tol=G.POS_TOL):
    return abs(a - b) <= tol


# --------------------------------------------------------------------------
# Outline helpers
# --------------------------------------------------------------------------
def loop_closed(segments, tol=G.POS_TOL):
    """True if segments form exactly one closed loop (every vertex degree 2,
    single connected component)."""
    if not segments:
        return False, "no Edge.Cuts segments"
    verts: list[tuple[float, float]] = []

    def vid(p):
        for i, v in enumerate(verts):
            if math.dist(v, p) <= tol:
                return i
        verts.append(p)
        return len(verts) - 1

    adj: dict[int, list[int]] = {}
    for a, b in segments:
        ia, ib = vid(a), vid(b)
        adj.setdefault(ia, []).append(ib)
        adj.setdefault(ib, []).append(ia)
    bad = [verts[i] for i, n in adj.items() if len(n) != 2]
    if bad:
        return False, f"open/branching vertices at {bad}"
    seen, todo = set(), [0]
    while todo:
        v = todo.pop()
        if v in seen:
            continue
        seen.add(v)
        todo.extend(adj[v])
    if len(seen) != len(verts):
        return False, f"{len(verts) - len(seen)} vertices in a second loop"
    return True, f"{len(segments)} segments, {len(verts)} vertices, single loop"


def polygon_area(segments):
    return 0.5 * abs(sum(a[0] * b[1] - b[0] * a[1] for a, b in segments))


def bbox(points):
    xs = [p[0] for p in points]
    ys = [p[1] for p in points]
    return min(xs), min(ys), max(xs), max(ys)


def check_envelope(rep, tag, segments, y_sign=1):
    pts = [p for s in segments for p in s]
    ok, why = loop_closed(segments)
    rep.add(f"{tag}-closed", f"{tag}: Edge.Cuts forms one closed loop", ok, why)
    x0, y0, x1, y1 = bbox(pts)
    if y_sign < 0:
        y0, y1 = -y1, -y0
    want = (0.0, 0.0, G.BOARD_W, G.BOARD_H)
    got = (x0, y0, x1, y1)
    rep.add(f"{tag}-bbox", f"{tag}: extents exactly (0,0)-({G.BOARD_W},{G.BOARD_H}) mm",
            all(close(a, b) for a, b in zip(got, want)),
            "got (%.4f,%.4f)-(%.4f,%.4f)" % got)
    area = polygon_area(segments)
    rep.add(f"{tag}-area", f"{tag}: enclosed area = {G.BOARD_W * G.BOARD_H:.1f} mm^2 (rectangular, no notches)",
            close(area, G.BOARD_W * G.BOARD_H, 1e-3), f"{area:.4f} mm^2")
    axis = all(close(a[0], b[0]) or close(a[1], b[1]) for a, b in segments)
    rep.add(f"{tag}-ortho", f"{tag}: all edges axis-aligned", axis)


# --------------------------------------------------------------------------
# PCB checks
# --------------------------------------------------------------------------
def rotate(px, py, deg):
    r = math.radians(-deg)  # KiCad: positive angle = CCW on screen (Y down)
    return px * math.cos(r) - py * math.sin(r), px * math.sin(r) + py * math.cos(r)
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
