SREESAIARJUN/radxa-cm4-nano-carrier/(commit log)

2026-11-05 feat: initial hardware design, KiCad 8 files, Gerbers, and DXF outlines
    [board_outline.dxf, outline_v1.dxf, outline_v10.dxf, outline_v11.dxf, outline_v12.dxf, outline_v13.dxf, outline_v14.dxf, outline_v2.dxf]
2026-11-05 feat: autonomous hardware engineering iteration (2026-11-05 20:30 UTC)
    [board_outline.dxf, outline_v1.dxf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]
2026-11-05 feat: autonomous hardware engineering iteration (2026-11-05 20:34 UTC)
    [board_outline.dxf, outline_v2.dxf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]
2026-11-05 feat: autonomous hardware engineering iteration (2026-11-05 20:36 UTC)
    [board_outline.dxf, outline_v1.dxf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]
2026-11-05 feat: autonomous hardware engineering iteration (2026-11-05 20:37 UTC)
    [board_outline.dxf, outline_v1.dxf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]
2026-11-05 feat: autonomous hardware engineering iteration (2026-11-05 20:40 UTC)
    [board_outline.dxf, outline_v2.dxf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]
2026-11-05 feat: autonomous hardware engineering iteration (2026-11-05 20:43 UTC)
    [board_outline.dxf, outline_v3.dxf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]
2026-11-05 feat: autonomous hardware engineering iteration (2026-11-05 20:46 UTC)
    [board_outline.dxf, outline_v4.dxf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]
2026-11-05 feat: autonomous hardware engineering iteration (2026-11-05 20:50 UTC)
    [board_outline.dxf, outline_v5.dxf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]
2026-11-05 feat: autonomous hardware engineering release (2026-11-05 21:00 UTC)
    [board_outline.dxf, outline_v6.dxf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]
2026-11-05 feat: autonomous hardware engineering release (2026-11-05 21:02 UTC)
    [radxa-cm4-nano-carrier-B_Courtyard.gbr, radxa-cm4-nano-carrier-B_Cu.gbl, radxa-cm4-nano-carrier-B_Mask.gbs, radxa-cm4-nano-carrier-B_Silkscreen.gbo, radxa-cm4-nano-carrier-Edge_Cuts.gm1, radxa-cm4-nano-carrier-F_Courtyard.gbr, radxa-cm4-nano-carrier-F_Cu.gtl, radxa-cm4-nano-carrier-F_Mask.gts]
2026-11-05 feat: autonomous hardware engineering release (2026-11-05 21:04 UTC)
    [radxa-cm4-nano-carrier-B_Courtyard.gbr, radxa-cm4-nano-carrier-B_Cu.gbl, radxa-cm4-nano-carrier-B_Mask.gbs, radxa-cm4-nano-carrier-B_Silkscreen.gbo, radxa-cm4-nano-carrier-Edge_Cuts.gm1, radxa-cm4-nano-carrier-F_Courtyard.gbr, radxa-cm4-nano-carrier-F_Cu.gtl, radxa-cm4-nano-carrier-F_Mask.gts]
2026-11-05 feat: autonomous hardware engineering release (2026-11-05 21:06 UTC)
    [radxa-cm4-nano-carrier-B_Courtyard.gbr, radxa-cm4-nano-carrier-B_Cu.gbl, radxa-cm4-nano-carrier-B_Mask.gbs, radxa-cm4-nano-carrier-B_Silkscreen.gbo, radxa-cm4-nano-carrier-Edge_Cuts.gm1, radxa-cm4-nano-carrier-F_Courtyard.gbr, radxa-cm4-nano-carrier-F_Cu.gtl, radxa-cm4-nano-carrier-F_Mask.gts]
2026-11-05 feat: autonomous hardware engineering release (2026-11-05 21:08 UTC)
    [radxa-cm4-nano-carrier-B_Courtyard.gbr, radxa-cm4-nano-carrier-B_Cu.gbl, radxa-cm4-nano-carrier-B_Mask.gbs, radxa-cm4-nano-carrier-B_Silkscreen.gbo, radxa-cm4-nano-carrier-Edge_Cuts.gm1, radxa-cm4-nano-carrier-F_Courtyard.gbr, radxa-cm4-nano-carrier-F_Cu.gtl, radxa-cm4-nano-carrier-F_Mask.gts]
2026-11-05 feat: autonomous hardware engineering release (2026-11-05 21:11 UTC)
    [radxa-cm4-nano-carrier-B_Courtyard.gbr, radxa-cm4-nano-carrier-B_Cu.gbl, radxa-cm4-nano-carrier-B_Mask.gbs, radxa-cm4-nano-carrier-B_Silkscreen.gbo, radxa-cm4-nano-carrier-Edge_Cuts.gm1, radxa-cm4-nano-carrier-F_Courtyard.gbr, radxa-cm4-nano-carrier-F_Cu.gtl, radxa-cm4-nano-carrier-F_Mask.gts]
2026-11-05 feat: autonomous hardware engineering release (2026-11-05 21:13 UTC)
    [radxa-cm4-nano-carrier-B_Courtyard.gbr, radxa-cm4-nano-carrier-B_Cu.gbl, radxa-cm4-nano-carrier-B_Mask.gbs, radxa-cm4-nano-carrier-B_Silkscreen.gbo, radxa-cm4-nano-carrier-Edge_Cuts.gm1, radxa-cm4-nano-carrier-F_Courtyard.gbr, radxa-cm4-nano-carrier-F_Cu.gtl, radxa-cm4-nano-carrier-F_Mask.gts]
2026-11-05 feat: autonomous hardware engineering release (2026-11-05 21:14 UTC)
    [radxa-cm4-nano-carrier-B_Courtyard.gbr, radxa-cm4-nano-carrier-B_Cu.gbl, radxa-cm4-nano-carrier-B_Mask.gbs, radxa-cm4-nano-carrier-B_Silkscreen.gbo, radxa-cm4-nano-carrier-Edge_Cuts.gm1, radxa-cm4-nano-carrier-F_Courtyard.gbr, radxa-cm4-nano-carrier-F_Cu.gtl, radxa-cm4-nano-carrier-F_Mask.gts]
2026-11-05 feat: autonomous hardware engineering release (2026-11-05 21:17 UTC)
    [radxa-cm4-nano-carrier-B_Courtyard.gbr, radxa-cm4-nano-carrier-B_Cu.gbl, radxa-cm4-nano-carrier-B_Mask.gbs, radxa-cm4-nano-carrier-B_Silkscreen.gbo, radxa-cm4-nano-carrier-Edge_Cuts.gm1, radxa-cm4-nano-carrier-F_Courtyard.gbr, radxa-cm4-nano-carrier-F_Cu.gtl, radxa-cm4-nano-carrier-F_Mask.gts]
2026-11-05 feat: autonomous hardware engineering release (2026-11-05 21:19 UTC)
    [radxa-cm4-nano-carrier-B_Courtyard.gbr, radxa-cm4-nano-carrier-B_Cu.gbl, radxa-cm4-nano-carrier-B_Mask.gbs, radxa-cm4-nano-carrier-B_Silkscreen.gbo, radxa-cm4-nano-carrier-Edge_Cuts.gm1, radxa-cm4-nano-carrier-F_Courtyard.gbr, radxa-cm4-nano-carrier-F_Cu.gtl, radxa-cm4-nano-carrier-F_Mask.gts]
2026-11-05 feat: autonomous hardware engineering release (2026-11-05 21:21 UTC)
    [radxa-cm4-nano-carrier-B_Courtyard.gbr, radxa-cm4-nano-carrier-B_Cu.gbl, radxa-cm4-nano-carrier-B_Mask.gbs, radxa-cm4-nano-carrier-B_Silkscreen.gbo, radxa-cm4-nano-carrier-Edge_Cuts.gm1, radxa-cm4-nano-carrier-F_Courtyard.gbr, radxa-cm4-nano-carrier-F_Cu.gtl, radxa-cm4-nano-carrier-F_Mask.gts]
2026-11-05 feat: autonomous hardware engineering release (2026-11-05 21:23 UTC)
    [radxa-cm4-nano-carrier-B_Courtyard.gbr, radxa-cm4-nano-carrier-B_Cu.gbl, radxa-cm4-nano-carrier-B_Mask.gbs, radxa-cm4-nano-carrier-B_Silkscreen.gbo, radxa-cm4-nano-carrier-Edge_Cuts.gm1, radxa-cm4-nano-carrier-F_Courtyard.gbr, radxa-cm4-nano-carrier-F_Cu.gtl, radxa-cm4-nano-carrier-F_Mask.gts]
2026-11-05 feat: autonomous hardware engineering release (2026-11-05 21:25 UTC)
    [radxa-cm4-nano-carrier-B_Courtyard.gbr, radxa-cm4-nano-carrier-B_Cu.gbl, radxa-cm4-nano-carrier-B_Mask.gbs, radxa-cm4-nano-carrier-B_Silkscreen.gbo, radxa-cm4-nano-carrier-Edge_Cuts.gm1, radxa-cm4-nano-carrier-F_Courtyard.gbr, radxa-cm4-nano-carrier-F_Cu.gtl, radxa-cm4-nano-carrier-F_Mask.gts]
2026-11-05 feat: autonomous hardware engineering release (2026-11-05 21:27 UTC)
    [radxa-cm4-nano-carrier-B_Courtyard.gbr, radxa-cm4-nano-carrier-B_Cu.gbl, radxa-cm4-nano-carrier-B_Mask.gbs, radxa-cm4-nano-carrier-B_Silkscreen.gbo, radxa-cm4-nano-carrier-Edge_Cuts.gm1, radxa-cm4-nano-carrier-F_Courtyard.gbr, radxa-cm4-nano-carrier-F_Cu.gtl, radxa-cm4-nano-carrier-F_Mask.gts]
2026-11-05 feat: autonomous hardware engineering release (2026-11-05 21:29 UTC)
    [radxa-cm4-nano-carrier-B_Courtyard.gbr, radxa-cm4-nano-carrier-B_Cu.gbl, radxa-cm4-nano-carrier-B_Mask.gbs, radxa-cm4-nano-carrier-B_Silkscreen.gbo, radxa-cm4-nano-carrier-Edge_Cuts.gm1, radxa-cm4-nano-carrier-F_Courtyard.gbr, radxa-cm4-nano-carrier-F_Cu.gtl, radxa-cm4-nano-carrier-F_Mask.gts]
2026-11-05 feat: autonomous hardware engineering release (2026-11-05 21:31 UTC)
    [radxa-cm4-nano-carrier-B_Courtyard.gbr, radxa-cm4-nano-carrier-B_Cu.gbl, radxa-cm4-nano-carrier-B_Mask.gbs, radxa-cm4-nano-carrier-B_Silkscreen.gbo, radxa-cm4-nano-carrier-Edge_Cuts.gm1, radxa-cm4-nano-carrier-F_Courtyard.gbr, radxa-cm4-nano-carrier-F_Cu.gtl, radxa-cm4-nano-carrier-F_Mask.gts]
2026-11-05 feat: autonomous hardware engineering release (2026-11-05 21:33 UTC)
    [radxa-cm4-nano-carrier-B_Courtyard.gbr, radxa-cm4-nano-carrier-B_Cu.gbl, radxa-cm4-nano-carrier-B_Mask.gbs, radxa-cm4-nano-carrier-B_Silkscreen.gbo, radxa-cm4-nano-carrier-Edge_Cuts.gm1, radxa-cm4-nano-carrier-F_Courtyard.gbr, radxa-cm4-nano-carrier-F_Cu.gtl, radxa-cm4-nano-carrier-F_Mask.gts]
2026-11-05 feat: autonomous hardware engineering release (2026-11-05 21:35 UTC)
    [radxa-cm4-nano-carrier-B_Courtyard.gbr, radxa-cm4-nano-carrier-B_Cu.gbl, radxa-cm4-nano-carrier-B_Mask.gbs, radxa-cm4-nano-carrier-B_Silkscreen.gbo, radxa-cm4-nano-carrier-Edge_Cuts.gm1, radxa-cm4-nano-carrier-F_Courtyard.gbr, radxa-cm4-nano-carrier-F_Cu.gtl, radxa-cm4-nano-carrier-F_Mask.gts]
2026-11-05 feat: autonomous hardware engineering release (2026-11-05 21:37 UTC)
    [radxa-cm4-nano-carrier-B_Courtyard.gbr, radxa-cm4-nano-carrier-B_Cu.gbl, radxa-cm4-nano-carrier-B_Mask.gbs, radxa-cm4-nano-carrier-B_Silkscreen.gbo, radxa-cm4-nano-carrier-Edge_Cuts.gm1, radxa-cm4-nano-carrier-F_Courtyard.gbr, radxa-cm4-nano-carrier-F_Cu.gtl, radxa-cm4-nano-carrier-F_Mask.gts]
2026-11-05 feat: autonomous hardware engineering release (2026-11-05 21:39 UTC)
    [radxa-cm4-nano-carrier-B_Courtyard.gbr, radxa-cm4-nano-carrier-B_Cu.gbl, radxa-cm4-nano-carrier-B_Mask.gbs, radxa-cm4-nano-carrier-B_Silkscreen.gbo, radxa-cm4-nano-carrier-Edge_Cuts.gm1, radxa-cm4-nano-carrier-F_Courtyard.gbr, radxa-cm4-nano-carrier-F_Cu.gtl, radxa-cm4-nano-carrier-F_Mask.gts]
2026-11-05 feat: autonomous hardware engineering release (2026-11-05 21:41 UTC)
    [radxa-cm4-nano-carrier-B_Courtyard.gbr, radxa-cm4-nano-carrier-B_Cu.gbl, radxa-cm4-nano-carrier-B_Mask.gbs, radxa-cm4-nano-carrier-B_Silkscreen.gbo, radxa-cm4-nano-carrier-Edge_Cuts.gm1, radxa-cm4-nano-carrier-F_Courtyard.gbr, radxa-cm4-nano-carrier-F_Cu.gtl, radxa-cm4-nano-carrier-F_Mask.gts]
2026-11-05 feat: autonomous hardware engineering release (2026-11-05 21:43 UTC)
    [radxa-cm4-nano-carrier-B_Courtyard.gbr, radxa-cm4-nano-carrier-B_Cu.gbl, radxa-cm4-nano-carrier-B_Mask.gbs, radxa-cm4-nano-carrier-B_Silkscreen.gbo, radxa-cm4-nano-carrier-Edge_Cuts.gm1, radxa-cm4-nano-carrier-F_Courtyard.gbr, radxa-cm4-nano-carrier-F_Cu.gtl, radxa-cm4-nano-carrier-F_Mask.gts]
2026-11-05 feat: autonomous hardware engineering release (2026-11-05 21:45 UTC)
    [radxa-cm4-nano-carrier-B_Courtyard.gbr, radxa-cm4-nano-carrier-B_Cu.gbl, radxa-cm4-nano-carrier-B_Mask.gbs, radxa-cm4-nano-carrier-B_Silkscreen.gbo, radxa-cm4-nano-carrier-Edge_Cuts.gm1, radxa-cm4-nano-carrier-F_Courtyard.gbr, radxa-cm4-nano-carrier-F_Cu.gtl, radxa-cm4-nano-carrier-F_Mask.gts]
2026-11-05 feat: autonomous hardware engineering release (2026-11-05 21:47 UTC)
    [radxa-cm4-nano-carrier-B_Courtyard.gbr, radxa-cm4-nano-carrier-B_Cu.gbl, radxa-cm4-nano-carrier-B_Mask.gbs, radxa-cm4-nano-carrier-B_Silkscreen.gbo, radxa-cm4-nano-carrier-Edge_Cuts.gm1, radxa-cm4-nano-carrier-F_Courtyard.gbr, radxa-cm4-nano-carrier-F_Cu.gtl, radxa-cm4-nano-carrier-F_Mask.gts]
2026-11-05 feat: autonomous hardware engineering release (2026-11-05 21:49 UTC)
    [radxa-cm4-nano-carrier-B_Courtyard.gbr, radxa-cm4-nano-carrier-B_Cu.gbl, radxa-cm4-nano-carrier-B_Mask.gbs, radxa-cm4-nano-carrier-B_Silkscreen.gbo, radxa-cm4-nano-carrier-Edge_Cuts.gm1, radxa-cm4-nano-carrier-F_Courtyard.gbr, radxa-cm4-nano-carrier-F_Cu.gtl, radxa-cm4-nano-carrier-F_Mask.gts]
2026-11-05 feat: autonomous hardware engineering release (2026-11-05 21:51 UTC)
    [radxa-cm4-nano-carrier-B_Courtyard.gbr, radxa-cm4-nano-carrier-B_Cu.gbl, radxa-cm4-nano-carrier-B_Mask.gbs, radxa-cm4-nano-carrier-B_Silkscreen.gbo, radxa-cm4-nano-carrier-Edge_Cuts.gm1, radxa-cm4-nano-carrier-F_Courtyard.gbr, radxa-cm4-nano-carrier-F_Cu.gtl, radxa-cm4-nano-carrier-F_Mask.gts]
2026-11-05 feat: autonomous hardware engineering release (2026-11-05 21:53 UTC)
    [radxa-cm4-nano-carrier-B_Courtyard.gbr, radxa-cm4-nano-carrier-B_Cu.gbl, radxa-cm4-nano-carrier-B_Mask.gbs, radxa-cm4-nano-carrier-B_Silkscreen.gbo, radxa-cm4-nano-carrier-Edge_Cuts.gm1, radxa-cm4-nano-carrier-F_Courtyard.gbr, radxa-cm4-nano-carrier-F_Cu.gtl, radxa-cm4-nano-carrier-F_Mask.gts]
2026-11-05 feat: autonomous hardware engineering release (2026-11-05 21:55 UTC)
    [radxa-cm4-nano-carrier-B_Courtyard.gbr, radxa-cm4-nano-carrier-B_Cu.gbl, radxa-cm4-nano-carrier-B_Mask.gbs, radxa-cm4-nano-carrier-B_Silkscreen.gbo, radxa-cm4-nano-carrier-Edge_Cuts.gm1, radxa-cm4-nano-carrier-F_Courtyard.gbr, radxa-cm4-nano-carrier-F_Cu.gtl, radxa-cm4-nano-carrier-F_Mask.gts]
2026-11-05 feat: autonomous hardware engineering release (2026-11-05 21:57 UTC)
    [radxa-cm4-nano-carrier-B_Courtyard.gbr, radxa-cm4-nano-carrier-B_Cu.gbl, radxa-cm4-nano-carrier-B_Mask.gbs, radxa-cm4-nano-carrier-B_Silkscreen.gbo, radxa-cm4-nano-carrier-Edge_Cuts.gm1, radxa-cm4-nano-carrier-F_Courtyard.gbr, radxa-cm4-nano-carrier-F_Cu.gtl, radxa-cm4-nano-carrier-F_Mask.gts]
2026-11-05 feat: autonomous hardware engineering release (2026-11-05 21:59 UTC)
    [radxa-cm4-nano-carrier-B_Courtyard.gbr, radxa-cm4-nano-carrier-B_Cu.gbl, radxa-cm4-nano-carrier-B_Mask.gbs, radxa-cm4-nano-carrier-B_Silkscreen.gbo, radxa-cm4-nano-carrier-Edge_Cuts.gm1, radxa-cm4-nano-carrier-F_Courtyard.gbr, radxa-cm4-nano-carrier-F_Cu.gtl, radxa-cm4-nano-carrier-F_Mask.gts]
2026-11-05 feat: autonomous hardware engineering release (2026-11-05 22:01 UTC)
    [radxa-cm4-nano-carrier-B_Courtyard.gbr, radxa-cm4-nano-carrier-B_Cu.gbl, radxa-cm4-nano-carrier-B_Mask.gbs, radxa-cm4-nano-carrier-B_Silkscreen.gbo, radxa-cm4-nano-carrier-Edge_Cuts.gm1, radxa-cm4-nano-carrier-F_Courtyard.gbr, radxa-cm4-nano-carrier-F_Cu.gtl, radxa-cm4-nano-carrier-F_Mask.gts]
2026-11-06 feat(rev-6): autonomous engineering revision 6/150 [claude-opus-5-5]
    [radxa-cm4-nano-carrier-B_Courtyard.gbr, radxa-cm4-nano-carrier-B_Cu.gbl, radxa-cm4-nano-carrier-B_Mask.gbs, radxa-cm4-nano-carrier-B_Silkscreen.gbo, radxa-cm4-nano-carrier-Edge_Cuts.gm1, radxa-cm4-nano-carrier-F_Courtyard.gbr, radxa-cm4-nano-carrier-F_Cu.gtl, radxa-cm4-nano-carrier-F_Mask.gts]
2026-11-06 feat(rev-7): autonomous engineering revision 7/150 [claude-opus-5-5-fast]
    [board_outline.dxf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]
2026-11-06 feat(rev-8): autonomous engineering revision 8/150 [claude-opus-5-5]
    [radxa-cm4-nano-carrier-B_Courtyard.gbr, radxa-cm4-nano-carrier-B_Cu.gbl, radxa-cm4-nano-carrier-B_Fab.gbr, radxa-cm4-nano-carrier-B_Mask.gbs, radxa-cm4-nano-carrier-B_Paste.gbp, radxa-cm4-nano-carrier-B_Silkscreen.gbo, radxa-cm4-nano-carrier-Edge_Cuts.gm1, radxa-cm4-nano-carrier-F_Courtyard.gbr]
2026-11-06 feat(rev-9): autonomous engineering revision 9/150 [claude-opus-5-5-fast]
    [radxa-cm4-nano-carrier-B_Courtyard.gbr, radxa-cm4-nano-carrier-B_Cu.gbl, radxa-cm4-nano-carrier-B_Fab.gbr, radxa-cm4-nano-carrier-B_Mask.gbs, radxa-cm4-nano-carrier-B_Paste.gbp, radxa-cm4-nano-carrier-B_Silkscreen.gbo, radxa-cm4-nano-carrier-Edge_Cuts.gm1, radxa-cm4-nano-carrier-F_Courtyard.gbr]
2026-11-06 feat(rev-11): autonomous engineering revision 11/150 [claude-opus-5-5-fast]
    [radxa-cm4-nano-carrier-B_Courtyard.gbr, radxa-cm4-nano-carrier-B_Cu.gbl, radxa-cm4-nano-carrier-B_Fab.gbr, radxa-cm4-nano-carrier-B_Mask.gbs, radxa-cm4-nano-carrier-B_Paste.gbp, radxa-cm4-nano-carrier-B_Silkscreen.gbo, radxa-cm4-nano-carrier-Edge_Cuts.gm1, radxa-cm4-nano-carrier-F_Courtyard.gbr]
2026-11-06 feat(rev-13): autonomous engineering revision 13/150 [claude-opus-5-5-fast]
    [radxa-cm4-nano-carrier-B_Courtyard.gbr, radxa-cm4-nano-carrier-B_Cu.gbl, radxa-cm4-nano-carrier-B_Fab.gbr, radxa-cm4-nano-carrier-B_Mask.gbs, radxa-cm4-nano-carrier-B_Paste.gbp, radxa-cm4-nano-carrier-B_Silkscreen.gbo, radxa-cm4-nano-carrier-Edge_Cuts.gm1, radxa-cm4-nano-carrier-F_Courtyard.gbr]
2026-11-06 feat(rev-14): autonomous engineering revision 14/150 [claude-opus-5-5]
    [radxa-cm4-nano-carrier-B_Courtyard.gbr, radxa-cm4-nano-carrier-B_Cu.gbl, radxa-cm4-nano-carrier-B_Fab.gbr, radxa-cm4-nano-carrier-B_Mask.gbs, radxa-cm4-nano-carrier-B_Paste.gbp, radxa-cm4-nano-carrier-B_Silkscreen.gbo, radxa-cm4-nano-carrier-Edge_Cuts.gm1, radxa-cm4-nano-carrier-F_Courtyard.gbr]
2026-11-06 feat(rev-15): autonomous engineering revision 15/150 [claude-opus-5-5-fast]
    [board_outline.dxf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]
2026-11-06 feat(rev-16): autonomous engineering revision 16/150 [claude-opus-5-5]
    [radxa-cm4-nano-carrier-B_Courtyard.gbr, radxa-cm4-nano-carrier-B_Cu.gbl, radxa-cm4-nano-carrier-B_Fab.gbr, radxa-cm4-nano-carrier-B_Mask.gbs, radxa-cm4-nano-carrier-B_Paste.gbp, radxa-cm4-nano-carrier-B_Silkscreen.gbo, radxa-cm4-nano-carrier-Edge_Cuts.gm1, radxa-cm4-nano-carrier-F_Courtyard.gbr]
2026-11-06 feat(rev-17): autonomous engineering revision 17/150 [claude-opus-5-5-fast]
    [radxa-cm4-nano-carrier-B_Courtyard.gbr, radxa-cm4-nano-carrier-B_Cu.gbl, radxa-cm4-nano-carrier-B_Fab.gbr, radxa-cm4-nano-carrier-B_Mask.gbs, radxa-cm4-nano-carrier-B_Paste.gbp, radxa-cm4-nano-carrier-B_Silkscreen.gbo, radxa-cm4-nano-carrier-Edge_Cuts.gm1, radxa-cm4-nano-carrier-F_Courtyard.gbr]
2026-11-06 feat(rev-18): autonomous engineering revision 18/150 [claude-opus-5-5]
    [radxa-cm4-nano-carrier-B_Courtyard.gbr, radxa-cm4-nano-carrier-B_Cu.gbl, radxa-cm4-nano-carrier-B_Fab.gbr, radxa-cm4-nano-carrier-B_Mask.gbs, radxa-cm4-nano-carrier-B_Paste.gbp, radxa-cm4-nano-carrier-B_Silkscreen.gbo, radxa-cm4-nano-carrier-Edge_Cuts.gm1, radxa-cm4-nano-carrier-F_Courtyard.gbr]
2026-11-06 feat(rev-19): autonomous engineering revision 19/150 [claude-opus-5-5-fast]
    [radxa-cm4-nano-carrier-B_Courtyard.gbr, radxa-cm4-nano-carrier-B_Cu.gbl, radxa-cm4-nano-carrier-B_Fab.gbr, radxa-cm4-nano-carrier-B_Mask.gbs, radxa-cm4-nano-carrier-B_Paste.gbp, radxa-cm4-nano-carrier-B_Silkscreen.gbo, radxa-cm4-nano-carrier-Edge_Cuts.gm1, radxa-cm4-nano-carrier-F_Courtyard.gbr]
